alexander-armitage/AURA-FPGA/.github/aura_fpga.png

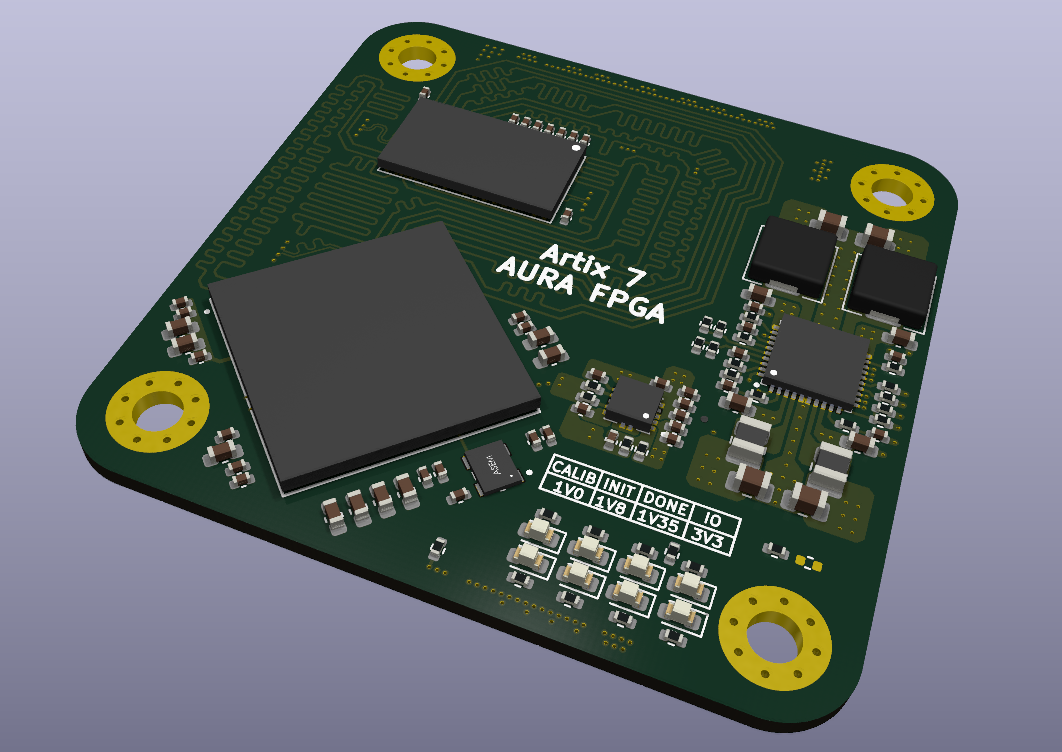
.github/aura_fpga.png
