alexander-armitage/AURA-FPGA/.github/aura_fpga_final_square.png

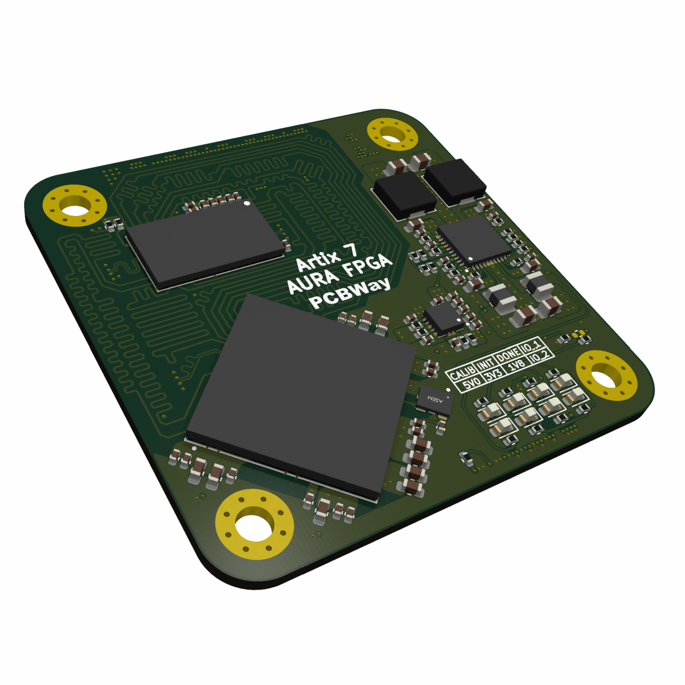
.github/aura_fpga_final_square.png
