alexander-armitage/AURA-FPGA/.github/aura_fpga_routing_square.png

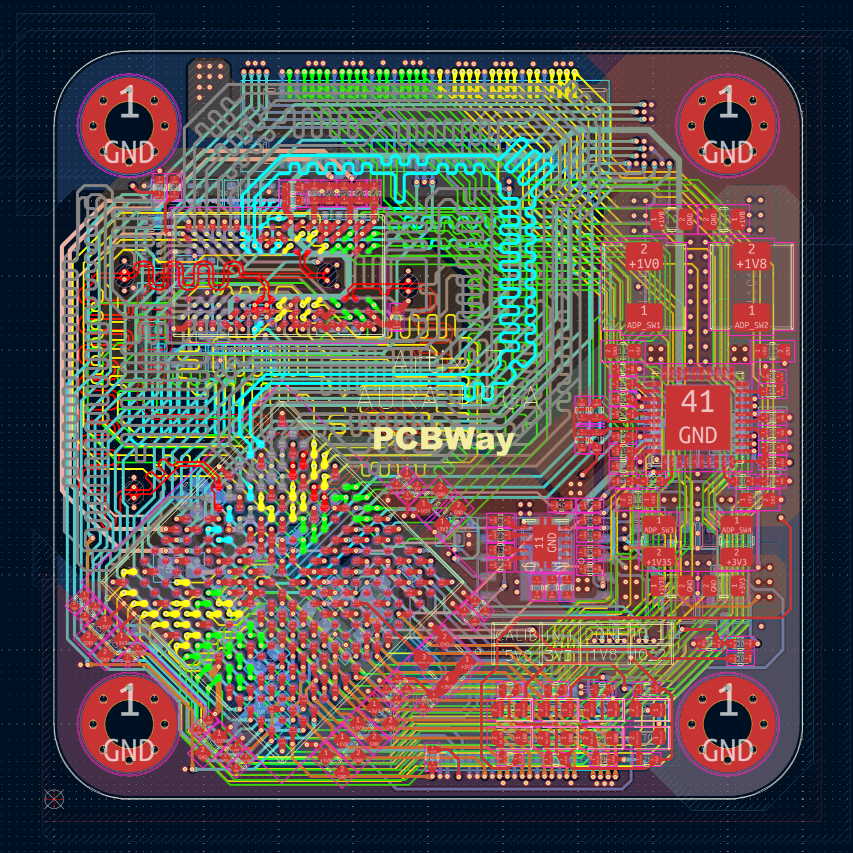
.github/aura_fpga_routing_square.png
