alexander-armitage/AURA-FPGA/FPGA_AURA/FPGA_AURA.kicad_pcb

## KiCad design FPGA_AURA/FPGA_AURA.kicad_pcb (2026-09-25)

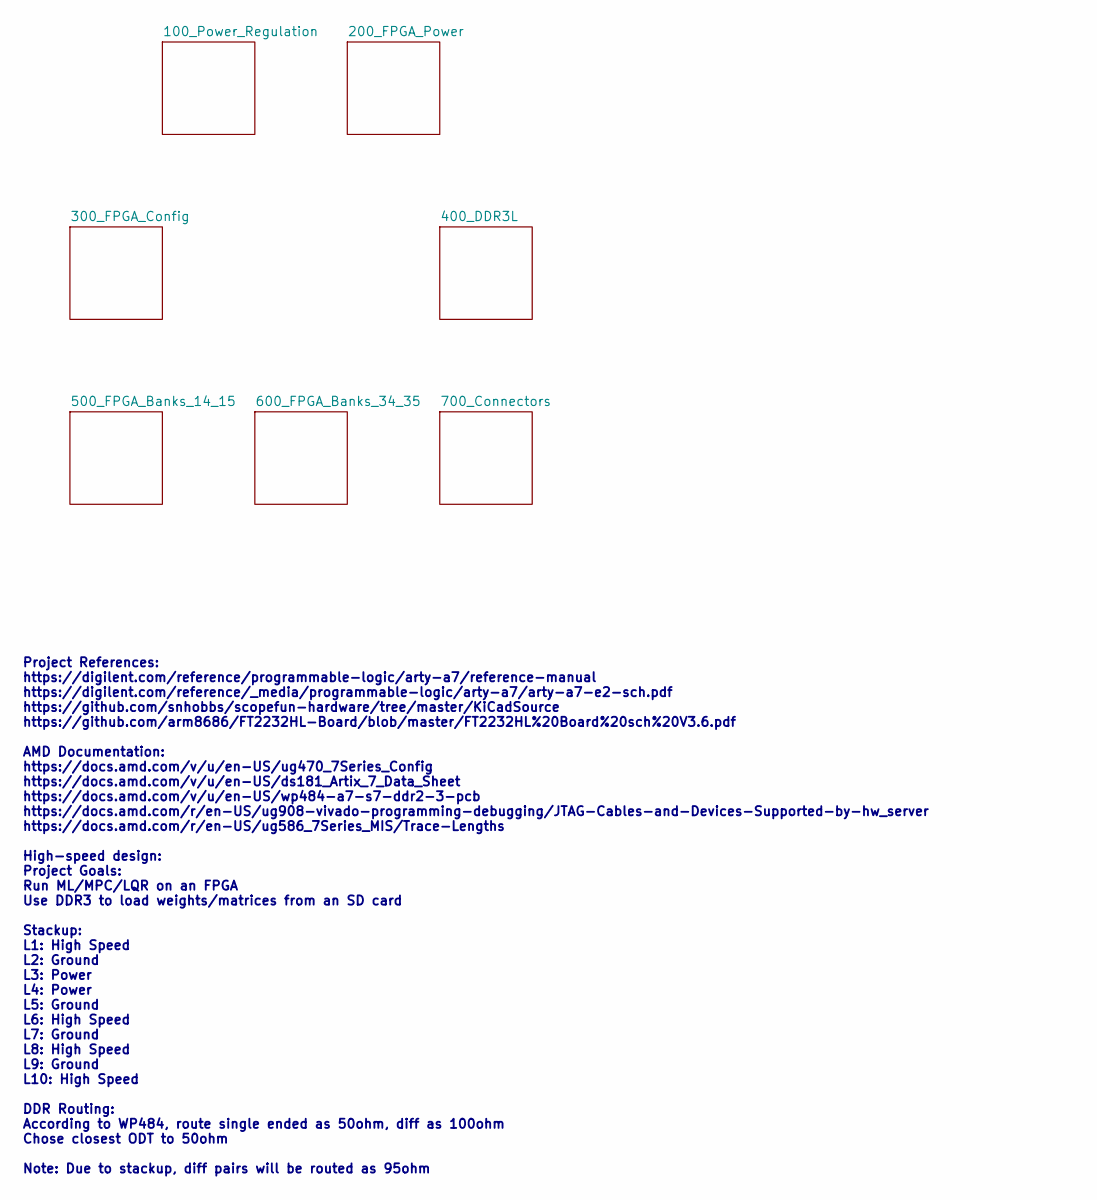
[picture p13: schematic FPGA_AURA.kicad_sch, FPGA AURA]

Notes on the sheet:
Project References: https://digilent.com/reference/programmable-logic/arty-a7/reference-manual https://digilent.com/reference/_media/programmable-logic/arty-a7/arty-a7-e2-sch.pdf https://github.com/snhobbs/scopefun-hardware/tree/master/KiCadSource https://github.com/arm8686/FT2232HL-Board/blob/mast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

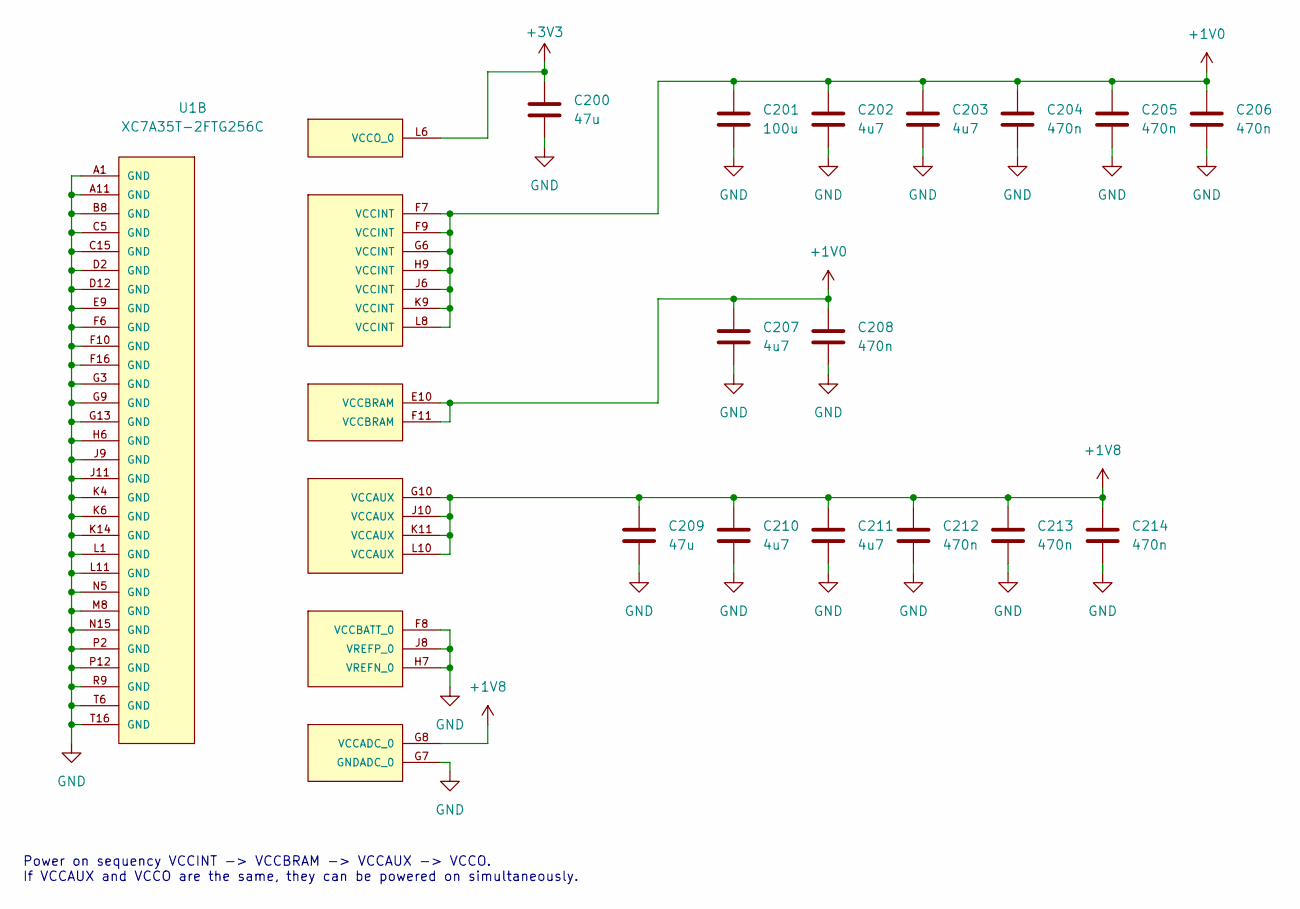
[picture p14: schematic FPGA_Power.kicad_sch, XC7A35T Power]

Parts:
C200, C209: 47u; C_0603_1608Metric
C201: 100u; C_0805_2012Metric
C202, C203, C207, C210, C211: 4u7; C_0603_1608Metric
C204, C205, C206, C208, C212, C213, C214: 470n; C_0402_1005Metric
U1: XC7A35T-2FTG256C; BGA256C100P16X16_1700X1700X155

Connections:
+1V0: C201.1, C202.1, C203.1, C204.1, C205.1, C206.1, C207.1, C208.1, U1.E10 (VCCBRAM), U1.F7 (VCCINT), U1.F9 (VCCINT), U1.F11 (VCCBRAM), U1.G6 (VCCINT), U1.H9 (VCCINT), U1.J6 (VCCINT), U1.K9 (VCCINT), U1.L8 (VCCINT); also elsewhere on the board
+1V8: C209.1, C210.1, C211.1, C212.1, C213.1, C214.1, U1.G8 (VCCADC_0), U1.G10 (VCCAUX), U1.J10 (VCCAUX), U1.K11 (VCCAUX), U1.L10 (VCCAUX); also elsewhere on the board
+3V3: C200.1, U1.L6 (VCCO_0); also elsewhere on the board
GND: C200.2, C201.2, C202.2, C203.2, C204.2, C205.2, C206.2, C207.2, C208.2, C209.2, C210.2, C211.2, C212.2, C213.2, C214.2, U1.A1 (GND), U1.A11 (GND), U1.B8 (GND), U1.C5 (GND), U1.C15 (GND), U1.D2 (GND), U1.D12 (GND), U1.E9 (GND), U1.F6 (GND), U1.F8 (VCCBATT_0), U1.F10 (GND), U1.F16 (GND), U1.G3 (GND), U1.G7 (GNDADC_0), U1.G9 (GND), U1.G13 (GND), U1.H6 (GND), U1.H7 (VREFN_0), U1.J8 (VREFP_0), U1.J9 (GND), U1.J11 (GND), U1.K4 (GND), U1.K6 (GND), U1.K14 (GND), U1.L1 (GND), U1.L11 (GND), U1.M8 (GND), U1.N5 (GND), U1.N15 (GND), U1.P2 (GND), U1.P12 (GND), U1.R9 (GND), U1.T6 (GND), U1.T16 (GND); also elsewhere on the board

Notes on the sheet:
Power on sequency VCCINT -> VCCBRAM -> VCCAUX -> VCCO. If VCCAUX and VCCO are the same, they can be powered on simultaneously.

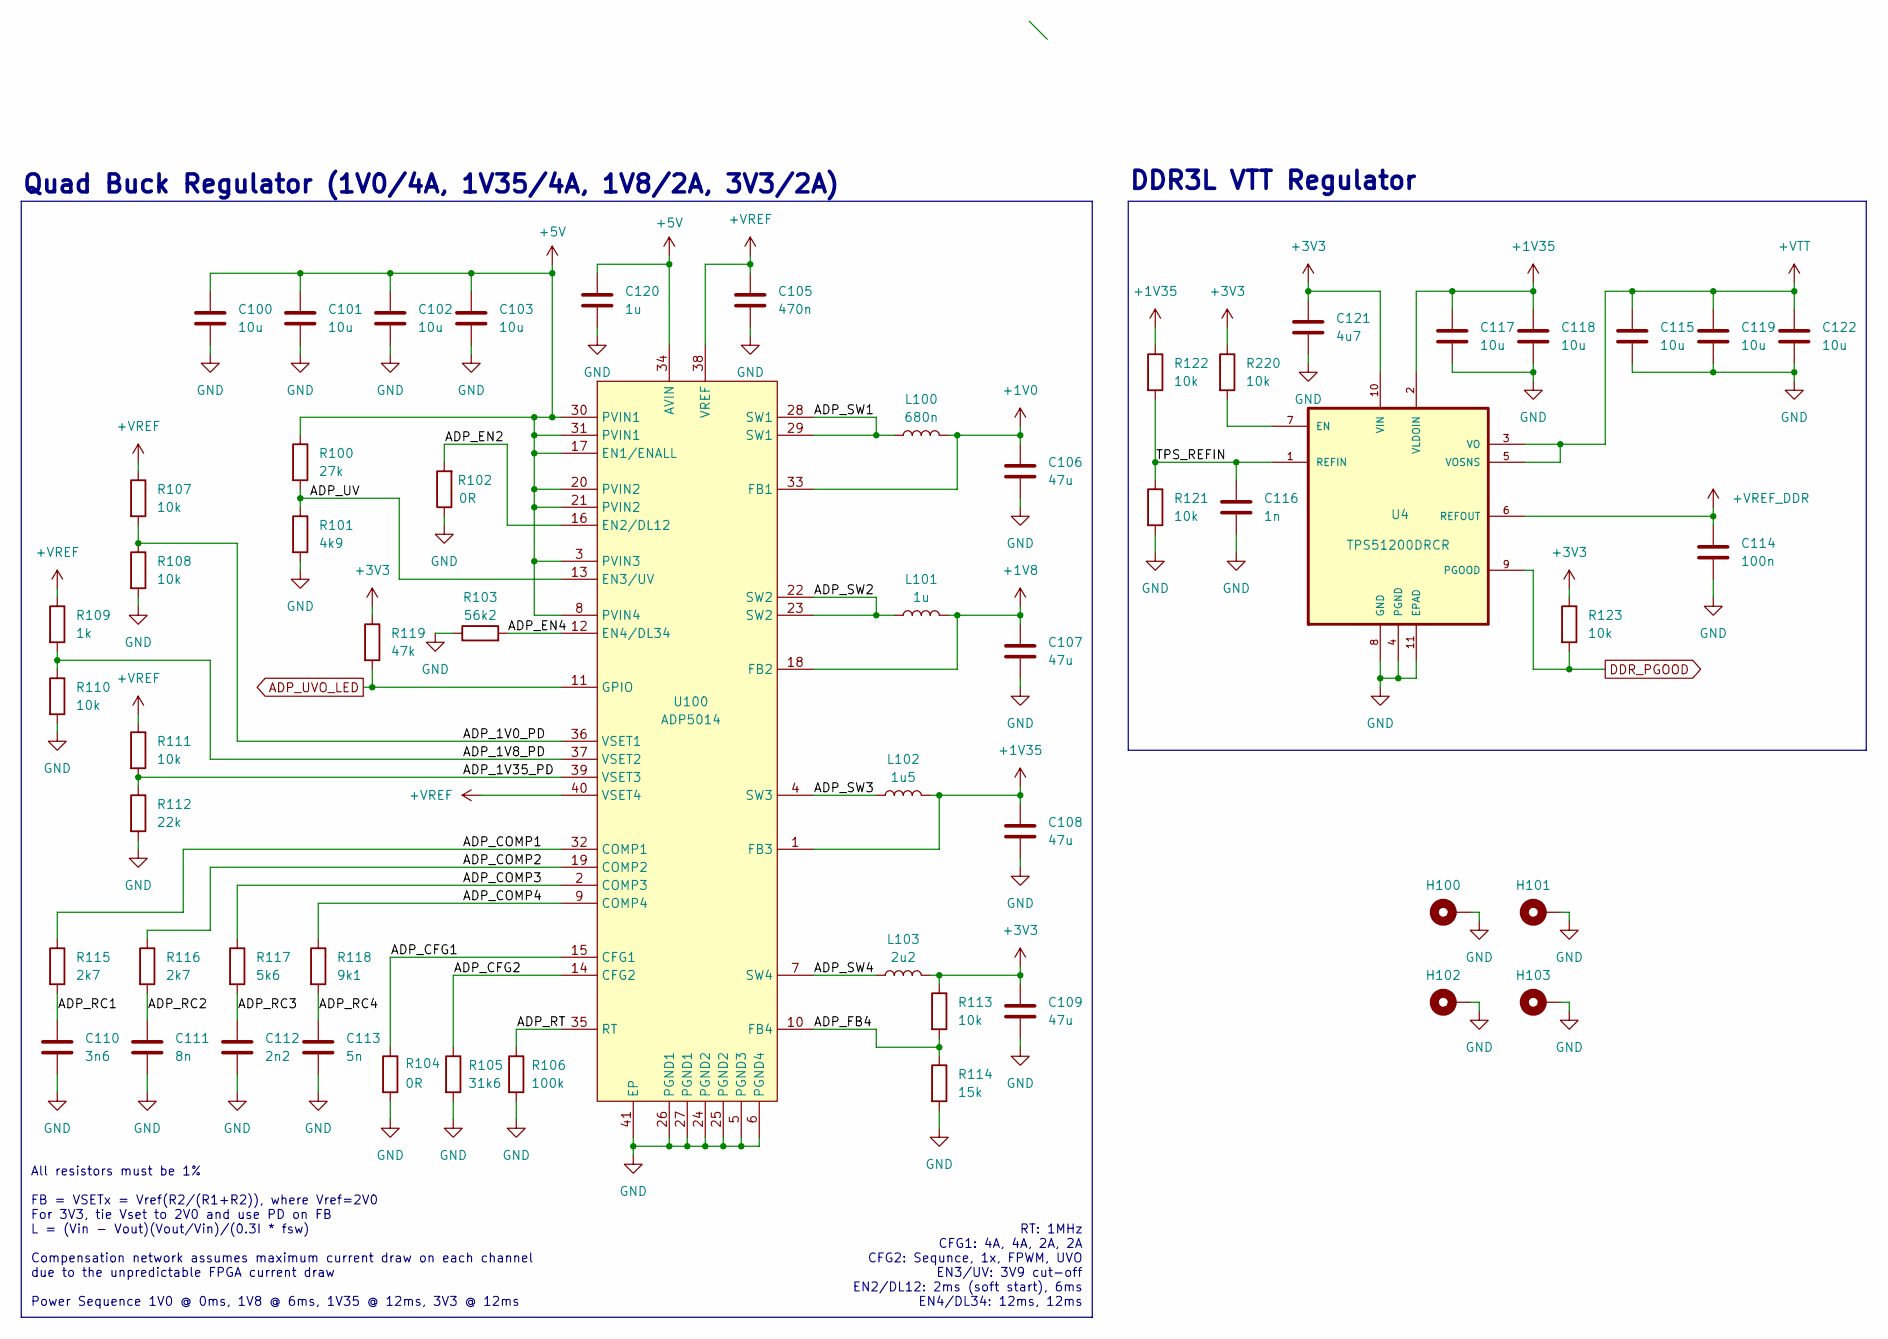
[picture p15: schematic Power_Regulation.kicad_sch, Power Regulation]

Parts:
C100, C101, C102, C103: 10u; C_0603_1608Metric
C105: 470n; C_0402_1005Metric
C106, C107, C108, C109: 47u; C_0805_2012Metric
C110: 3n6; C_0402_1005Metric
C111: 8n; C_0402_1005Metric
C112: 2n2; C_0402_1005Metric
C113: 5n; C_0402_1005Metric
C114: 100n; C_0402_1005Metric
C115, C117, C118, C119, C122: 10u; C_0402_1005Metric
C116: 1n; C_0402_1005Metric
C120: 1u; C_0402_1005Metric
C121: 4u7; C_0402_1005Metric
H100, H101, H102, H103: MountingHole_Pad; MountingHole_3.2mm_M3_Pad_Via
L100: 680n; L_Chilisin_BMRB00050518-B
L101: 1u; L_Chilisin_BMRB00050518-B
L102: 1u5; L_1008_2520Metric
L103: 2u2; L_1008_2520Metric
R100: 27k; R_0402_1005Metric
R101: 4k9; R_0402_1005Metric
R102, R104: 0R; R_0402_1005Metric
R103: 56k2; R_0402_1005Metric
R105: 31k6; R_0402_1005Metric
R106: 100k; R_0402_1005Metric
R107, R108, R110, R111, R113, R121, R122, R123, R220: 10k; R_0402_1005Metric
R109: 1k; R_0402_1005Metric
R112: 22k; R_0402_1005Metric
R114: 15k; R_0402_1005Metric
R115, R116: 2k7; R_0402_1005Metric
R117: 5k6; R_0402_1005Metric
R118: 9k1; R_0402_1005Metric
R119: 47k; R_0402_1005Metric
U4: TPS51200DRCR; VREG_V62_16624-01YE
U100: ADP5014; QFN50P600X600X80-41N430X430

Connections:
+1V0: C106.1, L100.2, U100.33 (FB1); also elsewhere on the board
+1V8: C107.1, L101.2, U100.18 (FB2); also elsewhere on the board
+1V35: C108.1, C117.1, C118.1, L102.2, R122.1, U4.2 (VLDOIN), U100.1 (FB3); also elsewhere on the board
+3V3: C109.1, C121.1, L103.2, R113.1, R119.1, R123.1, R220.1, U4.10 (VIN); also elsewhere on the board
+5V: C100.1, C101.1, C102.1, C103.1, C120.1, R100.1, U100.3 (PVIN3), U100.8 (PVIN4), U100.17 (EN1/ENALL), U100.20 (PVIN2), U100.21 (PVIN2), U100.30 (PVIN1), U100.31 (PVIN1), U100.34 (AVIN); also elsewhere on the board
+VREF: C105.1, R107.1, R109.1, R111.1, U100.38 (VREF), U100.40 (VSET4)
+VREF_DDR: C114.1, U4.6 (REFOUT); also elsewhere on the board
+VTT: C115.1, C119.1, C122.1, U4.3 (VO), U4.5 (VOSNS); also elsewhere on the board
/100_Power_Regulation/ADP_1V0_PD: R107.2, R108.1, U100.36 (VSET1)
/100_Power_Regulation/ADP_1V8_PD: R109.2, R110.1, U100.37 (VSET2)
/100_Power_Regulation/ADP_1V35_PD: R111.2, R112.1, U100.39 (VSET3)
/100_Power_Regulation/ADP_CFG1: R104.1, U100.15 (CFG1)
/100_Power_Regulation/ADP_CFG2: R105.1, U100.14 (CFG2)
/100_Power_Regulation/ADP_COMP1: R115.1, U100.32 (COMP1)
/100_Power_Regulation/ADP_COMP2: R116.1, U100.19 (COMP2)
/100_Power_Regulation/ADP_COMP3: R117.1, U100.2 (COMP3)
/100_Power_Regulation/ADP_COMP4: R118.1, U100.9 (COMP4)
/100_Power_Regulation/ADP_EN2: R102.2, U100.16 (EN2/DL12)
/100_Power_Regulation/ADP_EN4: R103.2, U100.12 (EN4/DL34)
/100_Power_Regulation/ADP_FB4: R113.2, R114.1, U100.10 (FB4)
/100_Power_Regulation/ADP_RC1: C110.1, R115.2
/100_Power_Regulation/ADP_RC2: C111.1, R116.2
/100_Power_Regulation/ADP_RC3: C112.1, R117.2
/100_Power_Regulation/ADP_RC4: C113.1, R118.2
/100_Power_Regulation/ADP_RT: R106.1, U100.35 (RT)
/100_Power_Regulation/ADP_SW1: L100.1, U100.28 (SW1), U100.29 (SW1)
/100_Power_Regulation/ADP_SW2: L101.1, U100.22 (SW2), U100.23 (SW2)
/100_Power_Regulation/ADP_SW3: L102.1, U100.4 (SW3)
/100_Power_Regulation/ADP_SW4: L103.1, U100.7 (SW4)
/100_Power_Regulation/ADP_UV: R100.2, R101.1, U100.13 (EN3/UV)
/100_Power_Regulation/TPS_REFIN: C116.1, R121.1, R122.2, U4.1 (REFIN)
ADP_UVO_LED: R119.2, U100.11 (GPIO)
DDR_PGOOD: R123.2, U4.9 (PGOOD)
GND: C100.2, C101.2, C102.2, C103.2, C105.2, C106.2, C107.2, C108.2, C109.2, C110.2, C111.2, C112.2, C113.2, C114.2, C115.2, C116.2, C117.2, C118.2, C119.2, C120.2, C121.2, C122.2, H100.1 (1_1), H101.1 (1_1), H102.1 (1_1), H103.1 (1_1), R101.2, R102.1, R103.1, R104.2, R105.2, R106.2, R108.2, R110.2, R112.2, R114.2, R121.2, U4.4 (PGND), U4.8 (GND), U4.11 (EPAD), U100.5 (PGND3), U100.6 (PGND4), U100.24 (PGND2), U100.25 (PGND2), U100.26 (PGND1), U100.27 (PGND1), U100.41 (EP); also elsewhere on the board
unnamed: R220.2, U4.7 (EN)

Notes on the sheet:
DDR3L VTT Regulator
Quad Buck Regulator (1V0/4A, 1V35/4A, 1V8/2A, 3V3/2A)
All resistors must be 1% FB = VSETx = Vref(R2/(R1+R2)), where Vref=2V0 For 3V3, tie Vset to 2V0 and use PD on FB L = (Vin - Vout)(Vout/Vin)/(0.3I * fsw) Compensation network assumes maximum current draw on each channel due to the unpredictable FPGA current draw Power Sequence 1V0 @ 0ms, 1V8 @ 6ms, 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
RT: 1MHz CFG1: 4A, 4A, 2A, 2A CFG2: Sequnce, 1x, FPWM, UVO EN3/UV: 3V9 cut-off EN2/DL12: 2ms (soft start), 6ms EN4/DL34: 12ms, 12ms

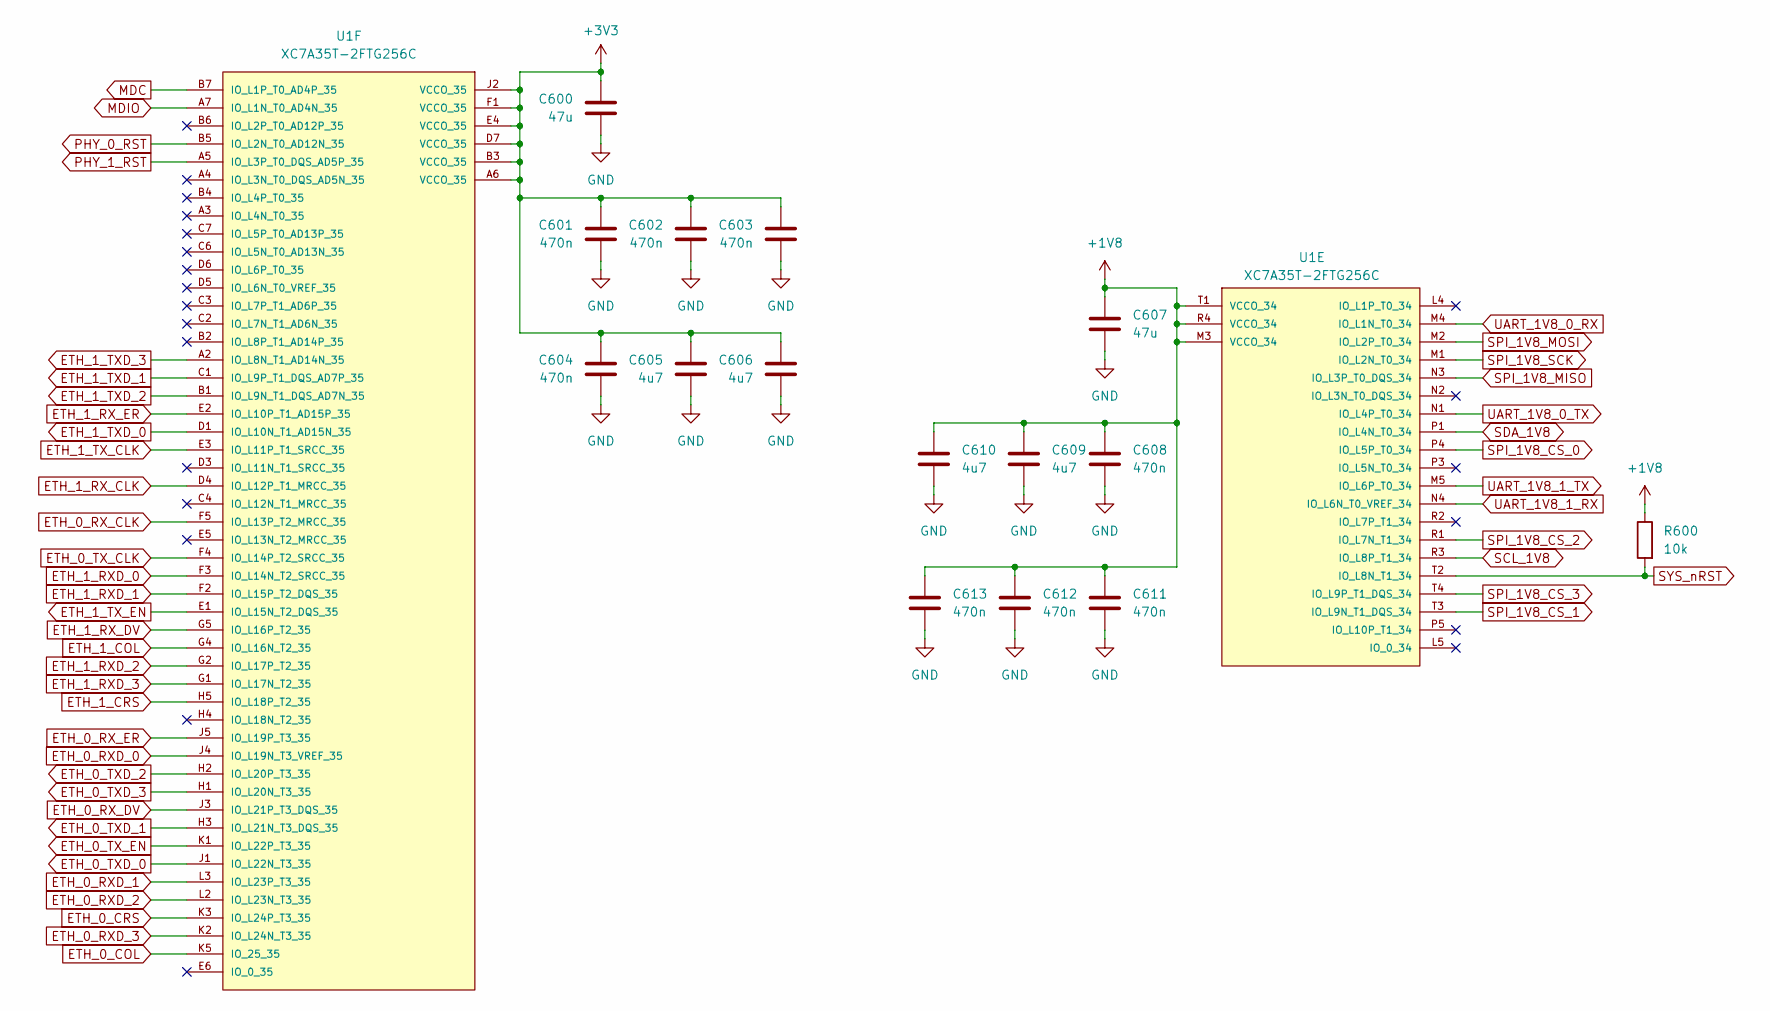
[picture p16: schematic FPGA_Banks_34_35.kicad_sch, XC7A35T Banks 34, 35]

Parts:
C600, C607: 47u; C_0603_1608Metric
C601, C602, C603, C604, C608, C611, C612, C613: 470n; C_0402_1005Metric
C605, C606, C609, C610: 4u7; C_0603_1608Metric
R600: 10k; R_0402_1005Metric
U1: XC7A35T-2FTG256C; BGA256C100P16X16_1700X1700X155

Connections:
+1V8: C607.1, C608.1, C609.1, C610.1, C611.1, C612.1, C613.1, R600.1, U1.M3 (VCCO_34), U1.R4 (VCCO_34), U1.T1 (VCCO_34); also elsewhere on the board
+3V3: C600.1, C601.1, C602.1, C603.1, C604.1, C605.1, C606.1, U1.A6 (VCCO_35), U1.B3 (VCCO_35), U1.D7 (VCCO_35), U1.E4 (VCCO_35), U1.F1 (VCCO_35), U1.J2 (VCCO_35); also elsewhere on the board
ETH_0_COL: U1.K5 (IO_25_35); also elsewhere on the board
ETH_0_CRS: U1.K3 (IO_L24P_T3_35); also elsewhere on the board
ETH_0_RXD_0: U1.J4 (IO_L19N_T3_VREF_35); also elsewhere on the board
ETH_0_RXD_1: U1.L3 (IO_L23P_T3_35); also elsewhere on the board
ETH_0_RXD_2: U1.L2 (IO_L23N_T3_35); also elsewhere on the board
ETH_0_RXD_3: U1.K2 (IO_L24N_T3_35); also elsewhere on the board
ETH_0_RX_CLK: U1.F5 (IO_L13P_T2_MRCC_35); also elsewhere on the board
ETH_0_RX_DV: U1.J3 (IO_L21P_T3_DQS_35); also elsewhere on the board
ETH_0_RX_ER: U1.J5 (IO_L19P_T3_35); also elsewhere on the board
ETH_0_TXD_0: U1.J1 (IO_L22N_T3_35); also elsewhere on the board
ETH_0_TXD_1: U1.H3 (IO_L21N_T3_DQS_35); also elsewhere on the board
ETH_0_TXD_2: U1.H2 (IO_L20P_T3_35); also elsewhere on the board
ETH_0_TXD_3: U1.H1 (IO_L20N_T3_35); also elsewhere on the board
ETH_0_TX_CLK: U1.F4 (IO_L14P_T2_SRCC_35); also elsewhere on the board
ETH_0_TX_EN: U1.K1 (IO_L22P_T3_35); also elsewhere on the board
ETH_1_COL: U1.G4 (IO_L16N_T2_35); also elsewhere on the board
ETH_1_CRS: U1.H5 (IO_L18P_T2_35); also elsewhere on the board
ETH_1_RXD_0: U1.F3 (IO_L14N_T2_SRCC_35); also elsewhere on the board
ETH_1_RXD_1: U1.F2 (IO_L15P_T2_DQS_35); also elsewhere on the board
ETH_1_RXD_2: U1.G2 (IO_L17P_T2_35); also elsewhere on the board
ETH_1_RXD_3: U1.G1 (IO_L17N_T2_35); also elsewhere on the board
ETH_1_RX_CLK: U1.D4 (IO_L12P_T1_MRCC_35); also elsewhere on the board
ETH_1_RX_DV: U1.G5 (IO_L16P_T2_35); also elsewhere on the board
ETH_1_RX_ER: U1.E2 (IO_L10P_T1_AD15P_35); also elsewhere on the board
ETH_1_TXD_0: U1.D1 (IO_L10N_T1_AD15N_35); also elsewhere on the board
ETH_1_TXD_1: U1.C1 (IO_L9P_T1_DQS_AD7P_35); also elsewhere on the board
ETH_1_TXD_2: U1.B1 (IO_L9N_T1_DQS_AD7N_35); also elsewhere on the board
ETH_1_TXD_3: U1.A2 (IO_L8N_T1_AD14N_35); also elsewhere on the board
ETH_1_TX_CLK: U1.E3 (IO_L11P_T1_SRCC_35); also elsewhere on the board
ETH_1_TX_EN: U1.E1 (IO_L15N_T2_DQS_35); also elsewhere on the board
GND: C600.2, C601.2, C602.2, C603.2, C604.2, C605.2, C606.2, C607.2, C608.2, C609.2, C610.2, C611.2, C612.2, C613.2; also elsewhere on the board
MDC: U1.B7 (IO_L1P_T0_AD4P_35); also elsewhere on the board
MDIO: U1.A7 (IO_L1N_T0_AD4N_35); also elsewhere on the board
PHY_0_RST: U1.B5 (IO_L2N_T0_AD12N_35); also elsewhere on the board
PHY_1_RST: U1.A5 (IO_L3P_T0_DQS_AD5P_35); also elsewhere on the board
SCL_1V8: U1.R3 (IO_L8P_T1_34); also elsewhere on the board
SDA_1V8: U1.P1 (IO_L4N_T0_34); also elsewhere on the board
SPI_1V8_CS_0: U1.P4 (IO_L5P_T0_34); also elsewhere on the board
SPI_1V8_CS_1: U1.T3 (IO_L9N_T1_DQS_34); also elsewhere on the board
SPI_1V8_CS_2: U1.R1 (IO_L7N_T1_34); also elsewhere on the board
SPI_1V8_CS_3: U1.T4 (IO_L9P_T1_DQS_34); also elsewhere on the board
SPI_1V8_MISO: U1.N3 (IO_L3P_T0_DQS_34); also elsewhere on the board
SPI_1V8_MOSI: U1.M2 (IO_L2P_T0_34); also elsewhere on the board
SPI_1V8_SCK: U1.M1 (IO_L2N_T0_34); also elsewhere on the board
SYS_nRST: R600.2, U1.T2 (IO_L8N_T1_34); also elsewhere on the board
UART_1V8_0_RX: U1.M4 (IO_L1N_T0_34); also elsewhere on the board
UART_1V8_0_TX: U1.N1 (IO_L4P_T0_34); also elsewhere on the board
UART_1V8_1_RX: U1.N4 (IO_L6N_T0_VREF_34); also elsewhere on the board
UART_1V8_1_TX: U1.M5 (IO_L6P_T0_34); also elsewhere on the board

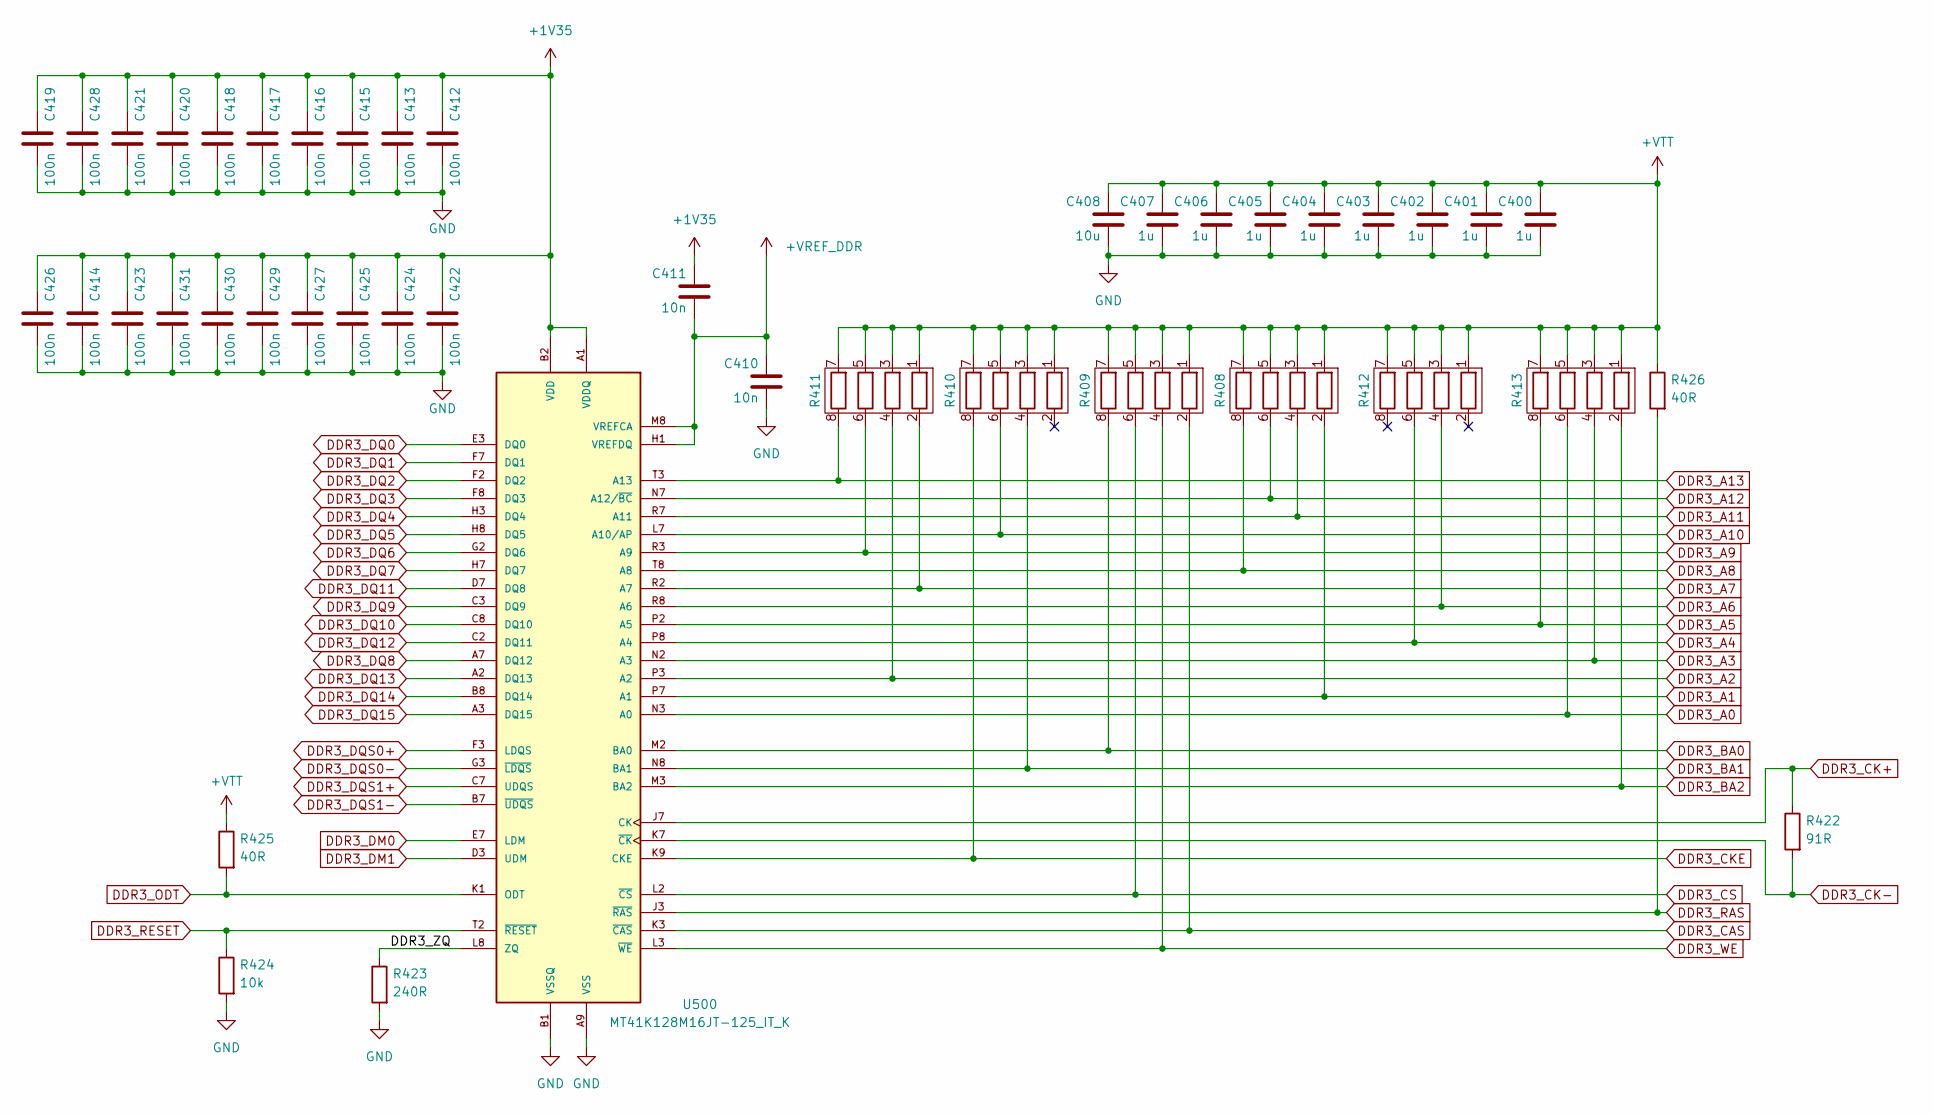
[picture p17: schematic DDR3L.kicad_sch]

Parts:
C400, C401, C402, C403, C404, C405, C406, C407: 1u; C_0402_1005Metric
C408: 10u; C_0402_1005Metric
C410, C411: 10n; C_0402_1005Metric
C412, C413, C417, C421, C422, C431: 100n; C_0402_1005Metric
C414, C415, C416, C418, C419, C420, C423, C424, C425, C426, C427, C428, C429, C430: 100n; C_0201_0603Metric
R408, R409, R410, R411, R412, R413: 40R2; 0402_4
R422: 91R; R_0201_0603Metric
R423: 240R; R_0402_1005Metric
R424: 10k; R_0402_1005Metric
R425, R426: 40R; R_0201_0603Metric
U500: MT41K128M16JT-125_IT_K; BGA80P96C6X16_800X1400X110

Connections:
+1V35: C411.1, C412.1, C413.1, C414.1, C415.1, C416.1, C417.1, C418.1, C419.1, C420.1, C421.1, C422.1, C423.1, C424.1, C425.1, C426.1, C427.1, C428.1, C429.1, C430.1, C431.1, U500.A1 (VDDQ), U500.A8 (VDDQ), U500.B2 (VDD), U500.C1 (VDDQ), U500.C9 (VDDQ), U500.D2 (VDDQ), U500.D9 (VDD), U500.E9 (VDDQ), U500.F1 (VDDQ), U500.G7 (VDD), U500.H2 (VDDQ), U500.H9 (VDDQ), U500.K2 (VDD), U500.K8 (VDD), U500.N1 (VDD), U500.N9 (VDD), U500.R1 (VDD), U500.R9 (VDD); also elsewhere on the board
+VREF_DDR: C410.1, C411.2, U500.H1 (VREFDQ), U500.M8 (VREFCA); also elsewhere on the board
+VTT: C400.1, C401.1, C402.1, C403.1, C404.1, C405.1, C406.1, C407.1, C408.1, R408.1, R408.3, R408.5, R408.7, R409.1, R409.3, R409.5, R409.7, R410.1, R410.3, R410.5, R410.7, R411.1, R411.3, R411.5, R411.7, R412.1, R412.3, R412.5, R412.7, R413.1, R413.3, R413.5, R413.7, R425.1, R426.1; also elsewhere on the board
/400_DDR3L/DDR3_ZQ: R423.1, U500.L8 (ZQ)
DDR3_A0: R413.6, U500.N3 (A0); also elsewhere on the board
DDR3_A1: R408.2, U500.P7 (A1); also elsewhere on the board
DDR3_A2: R411.4, U500.P3 (A2); also elsewhere on the board
DDR3_A3: R413.4, U500.N2 (A3); also elsewhere on the board
DDR3_A4: R412.6, U500.P8 (A4); also elsewhere on the board
DDR3_A5: R413.8, U500.P2 (A5); also elsewhere on the board
DDR3_A6: R412.4, U500.R8 (A6); also elsewhere on the board
DDR3_A7: R411.2, U500.R2 (A7); also elsewhere on the board
DDR3_A8: R408.8, U500.T8 (A8); also elsewhere on the board
DDR3_A9: R411.6, U500.R3 (A9); also elsewhere on the board
DDR3_A10: R410.6, U500.L7 (A10/AP); also elsewhere on the board
DDR3_A11: R408.4, U500.R7 (A11); also elsewhere on the board
DDR3_A12: R408.6, U500.N7 (A12/~BC); also elsewhere on the board
DDR3_A13: R411.8, U500.T3 (A13); also elsewhere on the board
DDR3_BA0: R409.8, U500.M2 (BA0); also elsewhere on the board
DDR3_BA1: R410.4, U500.N8 (BA1); also elsewhere on the board
DDR3_BA2: R413.2, U500.M3 (BA2); also elsewhere on the board
DDR3_CAS: R409.2, U500.K3 (~CAS); also elsewhere on the board
DDR3_CK+: R422.1, U500.J7 (CK); also elsewhere on the board
DDR3_CK-: R422.2, U500.K7 (~CK); also elsewhere on the board
DDR3_CKE: R410.8, U500.K9 (CKE); also elsewhere on the board
DDR3_CS: R409.6, U500.L2 (~CS); also elsewhere on the board
DDR3_DM0: U500.E7 (LDM); also elsewhere on the board
DDR3_DM1: U500.D3 (UDM); also elsewhere on the board
DDR3_DQ0: U500.E3 (DQ0); also elsewhere on the board
DDR3_DQ1: U500.F7 (DQ1); also elsewhere on the board
DDR3_DQ2: U500.F2 (DQ2); also elsewhere on the board
DDR3_DQ3: U500.F8 (DQ3); also elsewhere on the board
DDR3_DQ4: U500.H3 (DQ4); also elsewhere on the board
DDR3_DQ5: U500.H8 (DQ5); also elsewhere on the board
DDR3_DQ6: U500.G2 (DQ6); also elsewhere on the board
DDR3_DQ7: U500.H7 (DQ7); also elsewhere on the board
DDR3_DQ8: U500.A7 (DQ12); also elsewhere on the board
DDR3_DQ9: U500.C3 (DQ9); also elsewhere on the board
DDR3_DQ10: U500.C8 (DQ10); also elsewhere on the board
DDR3_DQ11: U500.D7 (DQ8); also elsewhere on the board
DDR3_DQ12: U500.C2 (DQ11); also elsewhere on the board
DDR3_DQ13: U500.A2 (DQ13); also elsewhere on the board
DDR3_DQ14: U500.B8 (DQ14); also elsewhere on the board
DDR3_DQ15: U500.A3 (DQ15); also elsewhere on the board
DDR3_DQS0+: U500.F3 (LDQS); also elsewhere on the board
DDR3_DQS0-: U500.G3 (~LDQS); also elsewhere on the board
DDR3_DQS1+: U500.C7 (UDQS); also elsewhere on the board
DDR3_DQS1-: U500.B7 (~UDQS); also elsewhere on the board
DDR3_ODT: R425.2, U500.K1 (ODT); also elsewhere on the board
DDR3_RAS: R426.2, U500.J3 (~RAS); also elsewhere on the board
DDR3_RESET: R424.1, U500.T2 (~RESET); also elsewhere on the board
DDR3_WE: R409.4, U500.L3 (~WE); also elsewhere on the board
GND: C400.2, C401.2, C402.2, C403.2, C404.2, C405.2, C406.2, C407.2, C408.2, C410.2, C412.2, C413.2, C414.2, C415.2, C416.2, C417.2, C418.2, C419.2, C420.2, C421.2, C422.2, C423.2, C424.2, C425.2, C426.2, C427.2, C428.2, C429.2, C430.2, C431.2, R423.2, R424.2, U500.A9 (VSS), U500.B1 (VSSQ), U500.B3 (VSS), U500.B9 (VSSQ), U500.D1 (VSSQ), U500.D8 (VSSQ), U500.E1 (VSS), U500.E2 (VSSQ), U500.E8 (VSSQ), U500.F9 (VSSQ), U500.G1 (VSSQ), U500.G8 (VSS), U500.G9 (VSSQ), U500.J2 (VSS), U500.J8 (VSS), U500.M1 (VSS), U500.M9 (VSS), U500.P1 (VSS), U500.P9 (VSS), U500.T1 (VSS), U500.T9 (VSS); also elsewhere on the board
