alexander-armitage/AURA-FPGA/FPGA_AURA/FPGA_AURA.kicad_pcb

## KiCad design FPGA_AURA/FPGA_AURA.kicad_pcb (continued)

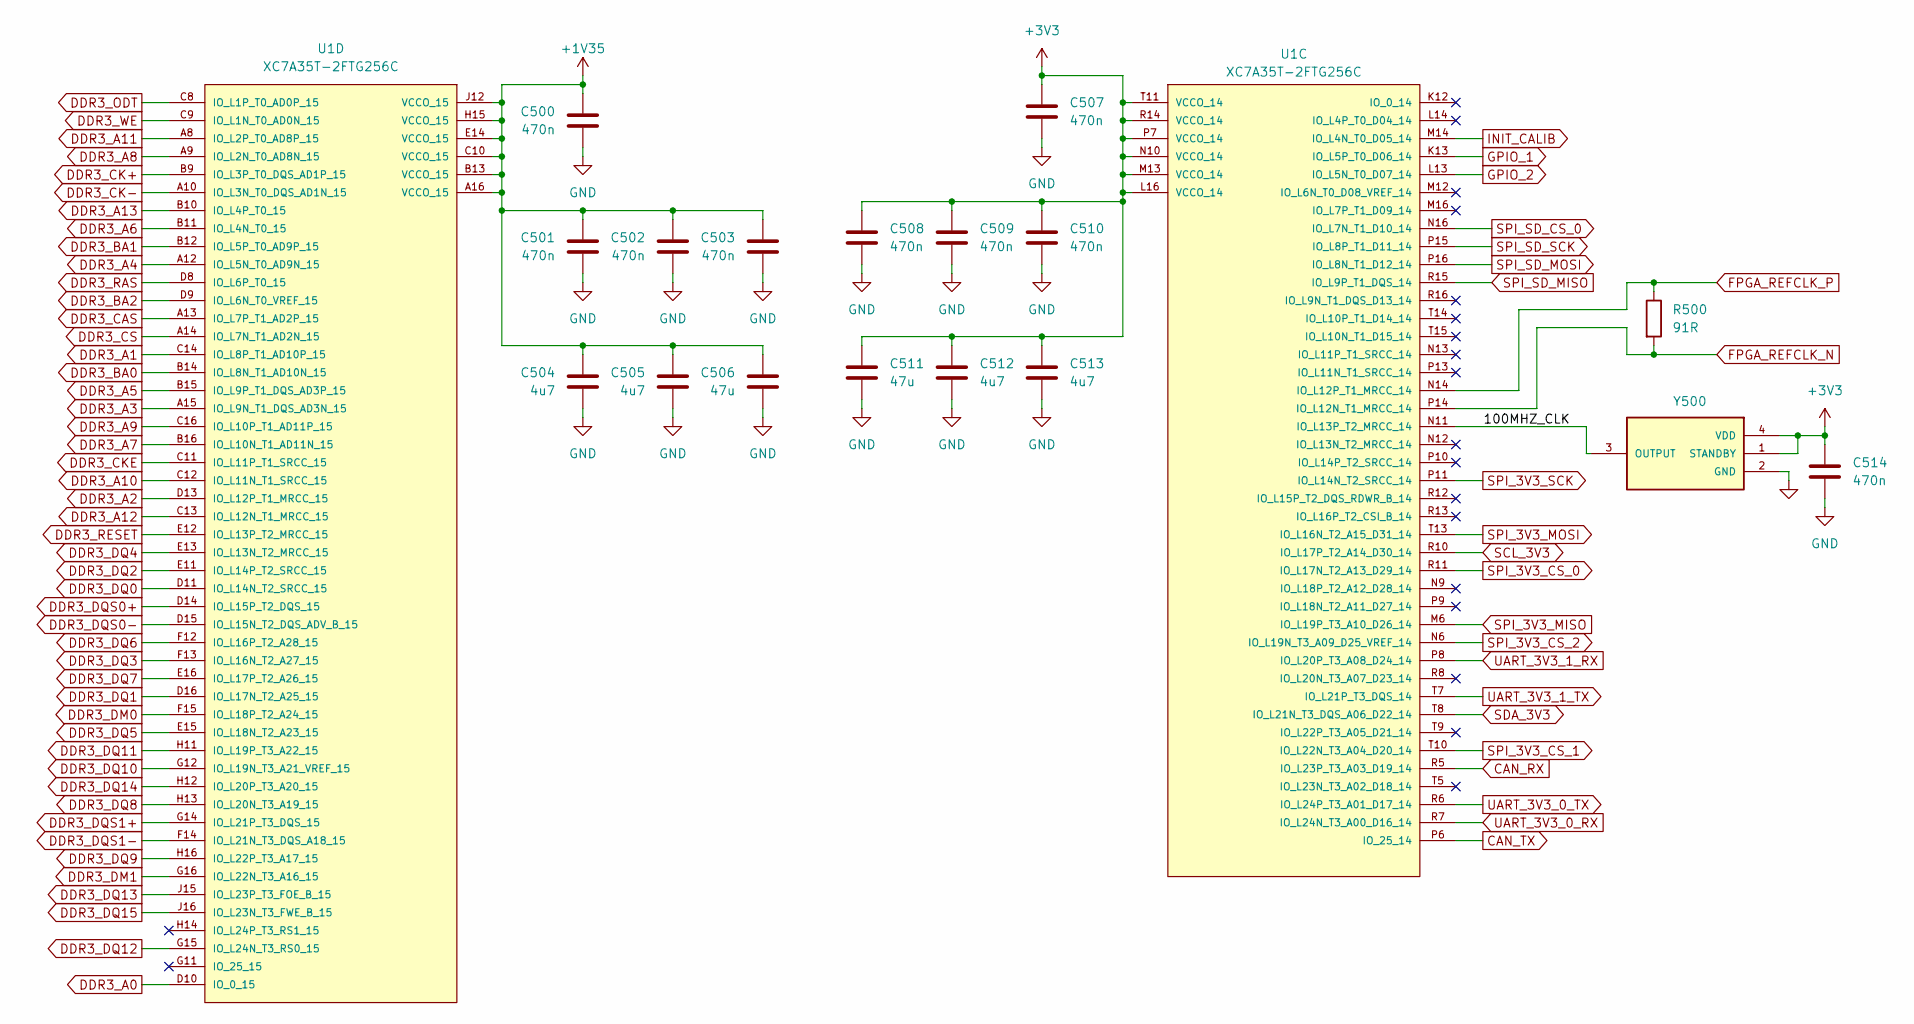
[picture p18: schematic FPGA_Banks_14_15.kicad_sch, XC7A35T Banks 14, 15]

Parts:
C500, C501, C502, C503, C507, C508, C509, C510, C514: 470n; C_0402_1005Metric
C504, C505, C512, C513: 4u7; C_0603_1608Metric
C506, C511: 47u; C_0603_1608Metric
R500: 91R; R_0201_0603Metric
U1: XC7A35T-2FTG256C; BGA256C100P16X16_1700X1700X155
Y500: ASEM1-100.000MHZ-LC-T; XTAL_ASEM1-100.000MHZ-LC-T; PARTREV 1.4.2021

Connections:
+1V35: C500.1, C501.1, C502.1, C503.1, C504.1, C505.1, C506.1, U1.A16 (VCCO_15), U1.B13 (VCCO_15), U1.C10 (VCCO_15), U1.E14 (VCCO_15), U1.H15 (VCCO_15), U1.J12 (VCCO_15); also elsewhere on the board
+3V3: C507.1, C508.1, C509.1, C510.1, C511.1, C512.1, C513.1, C514.1, U1.L16 (VCCO_14), U1.M13 (VCCO_14), U1.N10 (VCCO_14), U1.P7 (VCCO_14), U1.R14 (VCCO_14), U1.T11 (VCCO_14), Y500.1 (STANDBY), Y500.4 (VDD); also elsewhere on the board
/500_FPGA_Banks_14_15/100MHZ_CLK: U1.N11 (IO_L13P_T2_MRCC_14), Y500.3 (OUTPUT)
CAN_RX: U1.R5 (IO_L23P_T3_A03_D19_14); also elsewhere on the board
CAN_TX: U1.P6 (IO_25_14); also elsewhere on the board
DDR3_A0: U1.D10 (IO_0_15); also elsewhere on the board
DDR3_A1: U1.C14 (IO_L8P_T1_AD10P_15); also elsewhere on the board
DDR3_A2: U1.D13 (IO_L12P_T1_MRCC_15); also elsewhere on the board
DDR3_A3: U1.A15 (IO_L9N_T1_DQS_AD3N_15); also elsewhere on the board
DDR3_A4: U1.A12 (IO_L5N_T0_AD9N_15); also elsewhere on the board
DDR3_A5: U1.B15 (IO_L9P_T1_DQS_AD3P_15); also elsewhere on the board
DDR3_A6: U1.B11 (IO_L4N_T0_15); also elsewhere on the board
DDR3_A7: U1.B16 (IO_L10N_T1_AD11N_15); also elsewhere on the board
DDR3_A8: U1.A9 (IO_L2N_T0_AD8N_15); also elsewhere on the board
DDR3_A9: U1.C16 (IO_L10P_T1_AD11P_15); also elsewhere on the board
DDR3_A10: U1.C12 (IO_L11N_T1_SRCC_15); also elsewhere on the board
DDR3_A11: U1.A8 (IO_L2P_T0_AD8P_15); also elsewhere on the board
DDR3_A12: U1.C13 (IO_L12N_T1_MRCC_15); also elsewhere on the board
DDR3_A13: U1.B10 (IO_L4P_T0_15); also elsewhere on the board
DDR3_BA0: U1.B14 (IO_L8N_T1_AD10N_15); also elsewhere on the board
DDR3_BA1: U1.B12 (IO_L5P_T0_AD9P_15); also elsewhere on the board
DDR3_BA2: U1.D9 (IO_L6N_T0_VREF_15); also elsewhere on the board
DDR3_CAS: U1.A13 (IO_L7P_T1_AD2P_15); also elsewhere on the board
DDR3_CK+: U1.B9 (IO_L3P_T0_DQS_AD1P_15); also elsewhere on the board
DDR3_CK-: U1.A10 (IO_L3N_T0_DQS_AD1N_15); also elsewhere on the board
DDR3_CKE: U1.C11 (IO_L11P_T1_SRCC_15); also elsewhere on the board
DDR3_CS: U1.A14 (IO_L7N_T1_AD2N_15); also elsewhere on the board
DDR3_DM0: U1.F15 (IO_L18P_T2_A24_15); also elsewhere on the board
DDR3_DM1: U1.G16 (IO_L22N_T3_A16_15); also elsewhere on the board
DDR3_DQ0: U1.D11 (IO_L14N_T2_SRCC_15); also elsewhere on the board
DDR3_DQ1: U1.D16 (IO_L17N_T2_A25_15); also elsewhere on the board
DDR3_DQ2: U1.E11 (IO_L14P_T2_SRCC_15); also elsewhere on the board
DDR3_DQ3: U1.F13 (IO_L16N_T2_A27_15); also elsewhere on the board
DDR3_DQ4: U1.E13 (IO_L13N_T2_MRCC_15); also elsewhere on the board
DDR3_DQ5: U1.E15 (IO_L18N_T2_A23_15); also elsewhere on the board
DDR3_DQ6: U1.F12 (IO_L16P_T2_A28_15); also elsewhere on the board
DDR3_DQ7: U1.E16 (IO_L17P_T2_A26_15); also elsewhere on the board
DDR3_DQ8: U1.H13 (IO_L20N_T3_A19_15); also elsewhere on the board
DDR3_DQ9: U1.H16 (IO_L22P_T3_A17_15); also elsewhere on the board
DDR3_DQ10: U1.G12 (IO_L19N_T3_A21_VREF_15); also elsewhere on the board
DDR3_DQ11: U1.H11 (IO_L19P_T3_A22_15); also elsewhere on the board
DDR3_DQ12: U1.G15 (IO_L24N_T3_RS0_15); also elsewhere on the board
DDR3_DQ13: U1.J15 (IO_L23P_T3_FOE_B_15); also elsewhere on the board
DDR3_DQ14: U1.H12 (IO_L20P_T3_A20_15); also elsewhere on the board
DDR3_DQ15: U1.J16 (IO_L23N_T3_FWE_B_15); also elsewhere on the board
DDR3_DQS0+: U1.D14 (IO_L15P_T2_DQS_15); also elsewhere on the board
DDR3_DQS0-: U1.D15 (IO_L15N_T2_DQS_ADV_B_15); also elsewhere on the board
DDR3_DQS1+: U1.G14 (IO_L21P_T3_DQS_15); also elsewhere on the board
DDR3_DQS1-: U1.F14 (IO_L21N_T3_DQS_A18_15); also elsewhere on the board
DDR3_ODT: U1.C8 (IO_L1P_T0_AD0P_15); also elsewhere on the board
DDR3_RAS: U1.D8 (IO_L6P_T0_15); also elsewhere on the board
DDR3_RESET: U1.E12 (IO_L13P_T2_MRCC_15); also elsewhere on the board
DDR3_WE: U1.C9 (IO_L1N_T0_AD0N_15); also elsewhere on the board
FPGA_REFCLK_N: R500.2, U1.P14 (IO_L12N_T1_MRCC_14); also elsewhere on the board
FPGA_REFCLK_P: R500.1, U1.N14 (IO_L12P_T1_MRCC_14); also elsewhere on the board
GND: C500.2, C501.2, C502.2, C503.2, C504.2, C505.2, C506.2, C507.2, C508.2, C509.2, C510.2, C511.2, C512.2, C513.2, C514.2, Y500.2 (GND); also elsewhere on the board
GPIO_1: U1.K13 (IO_L5P_T0_D06_14); also elsewhere on the board
GPIO_2: U1.L13 (IO_L5N_T0_D07_14); also elsewhere on the board
INIT_CALIB: U1.M14 (IO_L4N_T0_D05_14); also elsewhere on the board
SCL_3V3: U1.R10 (IO_L17P_T2_A14_D30_14); also elsewhere on the board
SDA_3V3: U1.T8 (IO_L21N_T3_DQS_A06_D22_14); also elsewhere on the board
SPI_3V3_CS_0: U1.R11 (IO_L17N_T2_A13_D29_14); also elsewhere on the board
SPI_3V3_CS_1: U1.T10 (IO_L22N_T3_A04_D20_14); also elsewhere on the board
SPI_3V3_CS_2: U1.N6 (IO_L19N_T3_A09_D25_VREF_14); also elsewhere on the board
SPI_3V3_MISO: U1.M6 (IO_L19P_T3_A10_D26_14); also elsewhere on the board
SPI_3V3_MOSI: U1.T13 (IO_L16N_T2_A15_D31_14); also elsewhere on the board
SPI_3V3_SCK: U1.P11 (IO_L14N_T2_SRCC_14); also elsewhere on the board
SPI_SD_CS_0: U1.N16 (IO_L7N_T1_D10_14); also elsewhere on the board
SPI_SD_MISO: U1.R15 (IO_L9P_T1_DQS_14); also elsewhere on the board
SPI_SD_MOSI: U1.P16 (IO_L8N_T1_D12_14); also elsewhere on the board
SPI_SD_SCK: U1.P15 (IO_L8P_T1_D11_14); also elsewhere on the board
UART_3V3_0_RX: U1.R7 (IO_L24N_T3_A00_D16_14); also elsewhere on the board
UART_3V3_0_TX: U1.R6 (IO_L24P_T3_A01_D17_14); also elsewhere on the board
UART_3V3_1_RX: U1.P8 (IO_L20P_T3_A08_D24_14); also elsewhere on the board
UART_3V3_1_TX: U1.T7 (IO_L21P_T3_DQS_14); also elsewhere on the board

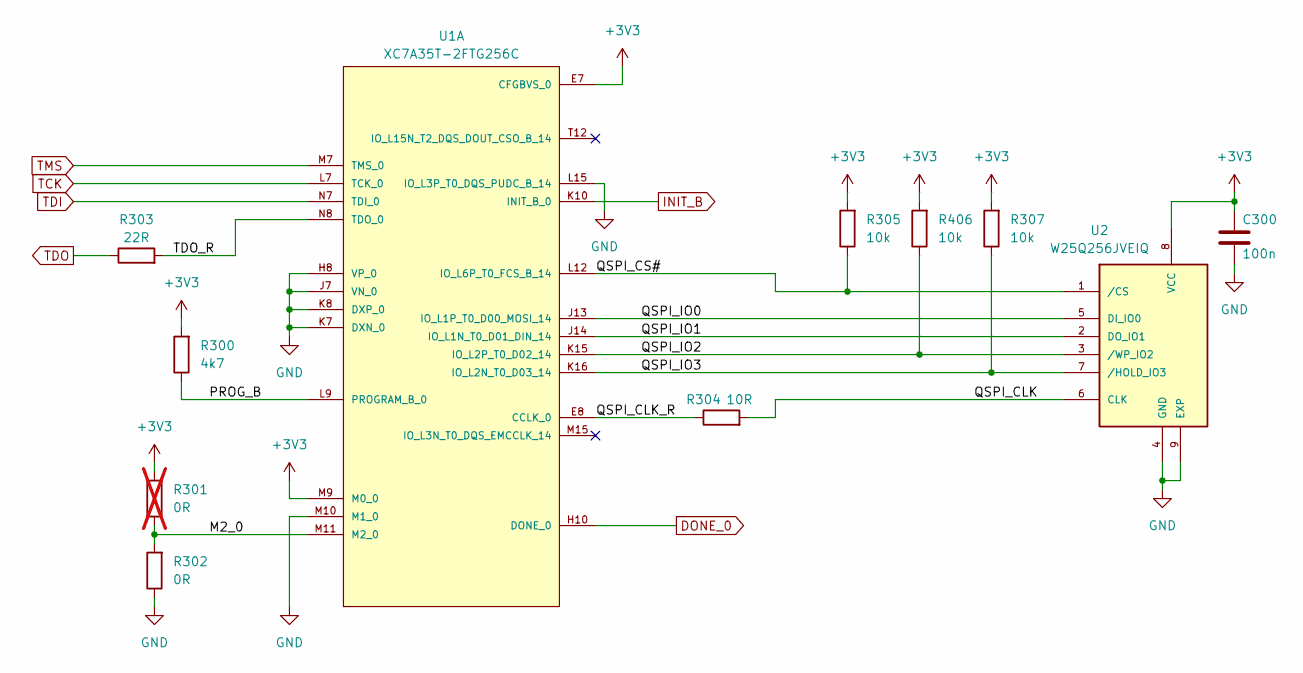
[picture p19: schematic FPGA_Config.kicad_sch, XC7A35T Configuration]

Parts:
C300: 100n; C_0402_1005Metric
R300: 4k7; R_0402_1005Metric
R301: 0R; R_0402_1005Metric; not fitted
R302: 0R; R_0402_1005Metric
R303: 22R; R_0402_1005Metric
R304: 10R; R_0402_1005Metric
R305, R307, R406: 10k; R_0402_1005Metric
U1: XC7A35T-2FTG256C; BGA256C100P16X16_1700X1700X155
U2: W25Q256JVEIQ; SON127P800X600X80-9N; MOUSER_PART_NUMBER 454-W25Q256JVEIQ

Connections:
+3V3: C300.1, R300.2, R301.2, R305.2, R307.2, R406.2, U1.E7 (CFGBVS_0), U1.M9 (M0_0), U2.8 (VCC); also elsewhere on the board
/300_FPGA_Config/M2_0: R301.1, R302.2, U1.M11 (M2_0)
/300_FPGA_Config/PROG_B: R300.1, U1.L9 (PROGRAM_B_0)
/300_FPGA_Config/QSPI_CLK: R304.2, U2.6 (CLK)
/300_FPGA_Config/QSPI_CLK_R: R304.1, U1.E8 (CCLK_0)
/300_FPGA_Config/QSPI_CS#: R305.1, U1.L12 (IO_L6P_T0_FCS_B_14), U2.1 (/CS)
/300_FPGA_Config/QSPI_IO0: U1.J13 (IO_L1P_T0_D00_MOSI_14), U2.5 (DI_IO0)
/300_FPGA_Config/QSPI_IO1: U1.J14 (IO_L1N_T0_D01_DIN_14), U2.2 (DO_IO1)
/300_FPGA_Config/QSPI_IO2: R406.1, U1.K15 (IO_L2P_T0_D02_14), U2.3 (/WP_IO2)
/300_FPGA_Config/QSPI_IO3: R307.1, U1.K16 (IO_L2N_T0_D03_14), U2.7 (/HOLD_IO3)
/300_FPGA_Config/TDO_R: R303.2, U1.N8 (TDO_0)
DONE_0: U1.H10 (DONE_0); also elsewhere on the board
GND: C300.2, R302.1, U1.H8 (VP_0), U1.J7 (VN_0), U1.K7 (DXN_0), U1.K8 (DXP_0), U1.L15 (IO_L3P_T0_DQS_PUDC_B_14), U1.M10 (M1_0), U2.4 (GND), U2.9 (EXP); also elsewhere on the board
INIT_B: U1.K10 (INIT_B_0); also elsewhere on the board
TCK: U1.L7 (TCK_0); also elsewhere on the board
TDI: U1.N7 (TDI_0); also elsewhere on the board
TDO: R303.1; also elsewhere on the board
TMS: U1.M7 (TMS_0); also elsewhere on the board

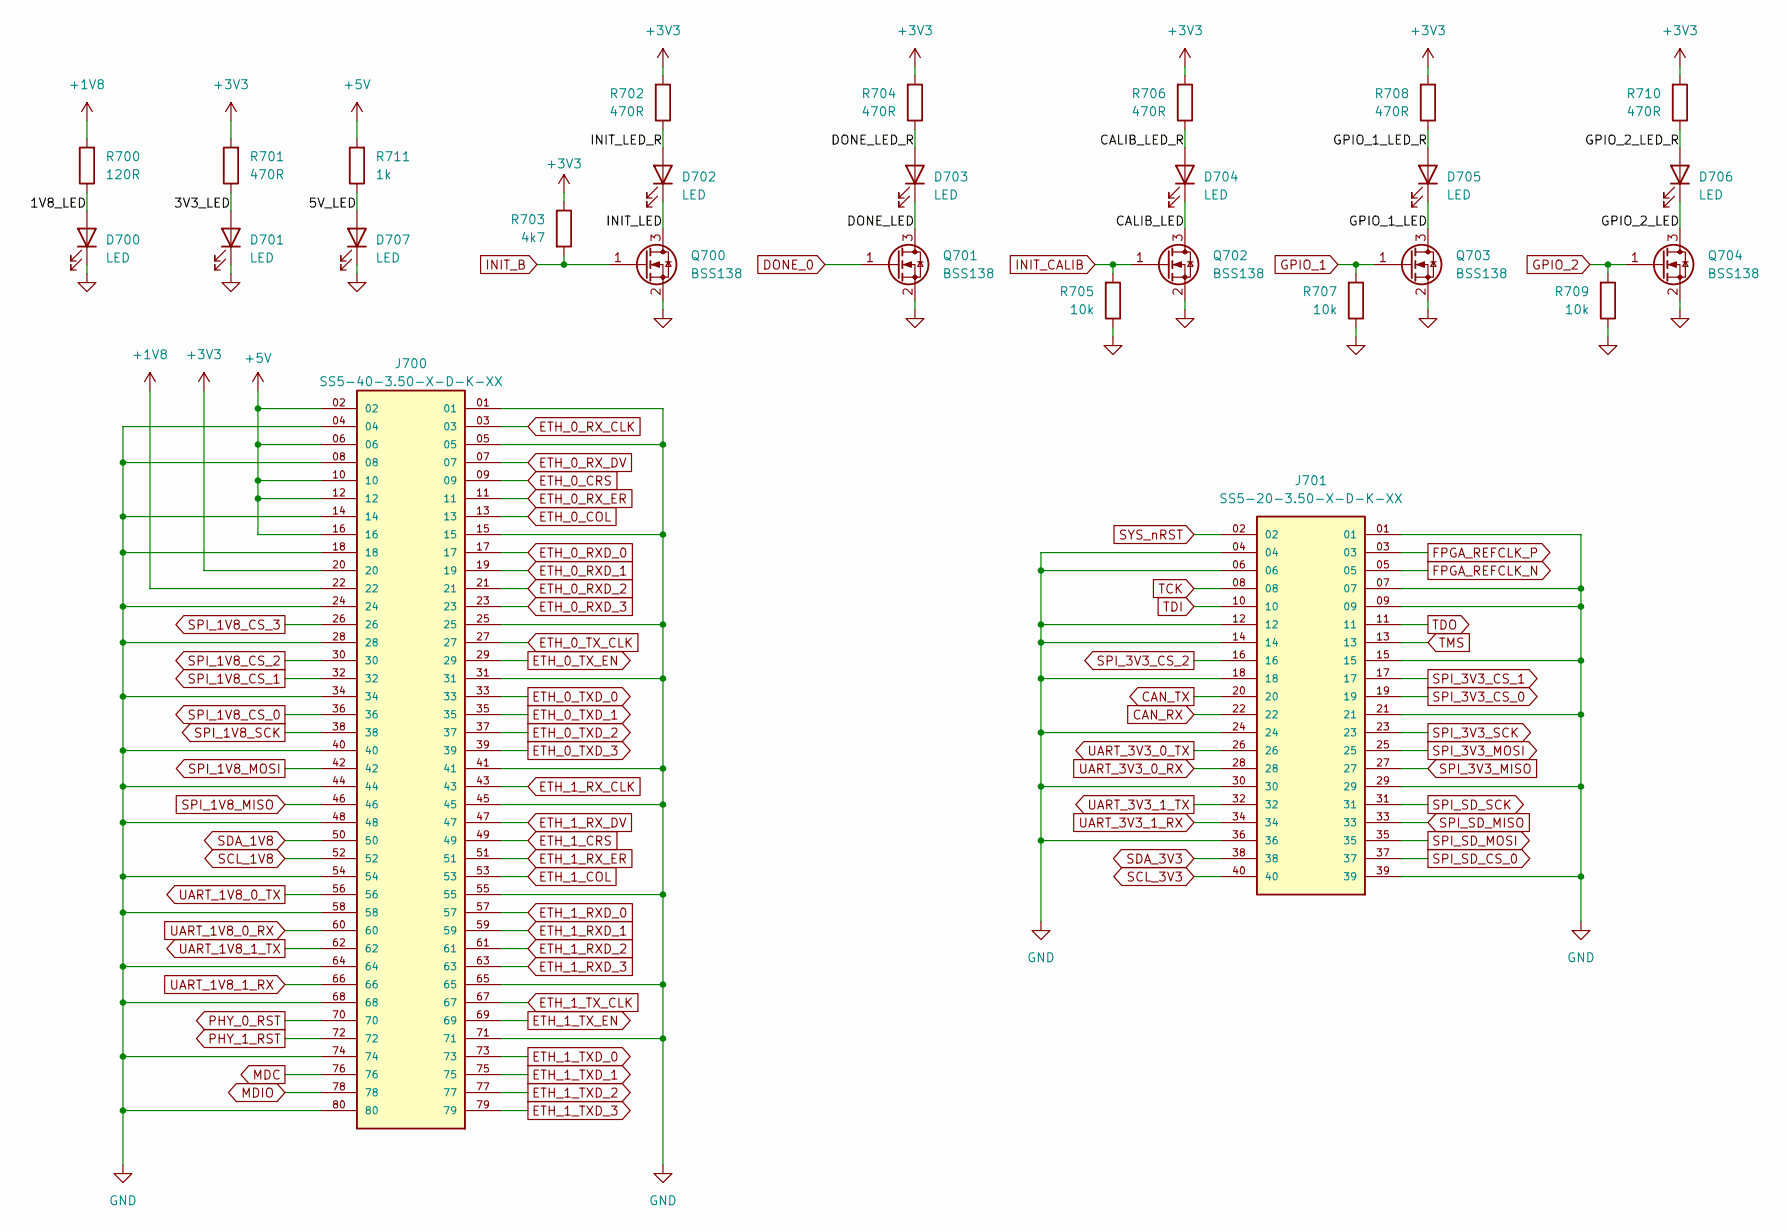
[picture p20: schematic Connectors.kicad_sch]

Parts:
D700, D701, D702, D703, D704, D705, D706, D707: LED; LED_0603_1608Metric
J700: SS5-40-3.50-X-D-K-XX; SAMTEC_SS5-40-3.50-X-D-K-XX; PARTREV F
J701: SS5-20-3.50-X-D-K-XX; SAMTEC_SS5-20-3.50-X-D-K-XX; PARTREV F
Q700, Q701, Q702, Q703, Q704: BSS138; SOT-23
R700: 120R; R_0402_1005Metric
R701, R702, R704, R706, R708, R710: 470R; R_0402_1005Metric
R703: 4k7; R_0402_1005Metric
R705, R707, R709: 10k; R_0402_1005Metric
R711: 1k; R_0402_1005Metric

Connections:
+1V8: J700.22, R700.2; also elsewhere on the board
+3V3: J700.20, R701.2, R702.2, R703.1, R704.2, R706.2, R708.2, R710.2; also elsewhere on the board
+5V: J700.02, J700.06, J700.10, J700.12, J700.16, R711.2; also elsewhere on the board
/700_Connectors/1V8_LED: D700.2 (A), R700.1
/700_Connectors/3V3_LED: D701.2 (A), R701.1
/700_Connectors/5V_LED: D707.2 (A), R711.1
/700_Connectors/CALIB_LED: D704.1 (K), Q702.3 (D)
/700_Connectors/CALIB_LED_R: D704.2 (A), R706.1
/700_Connectors/DONE_LED: D703.1 (K), Q701.3 (D)
/700_Connectors/DONE_LED_R: D703.2 (A), R704.1
/700_Connectors/GPIO_1_LED: D705.1 (K), Q703.3 (D)
/700_Connectors/GPIO_1_LED_R: D705.2 (A), R708.1
/700_Connectors/GPIO_2_LED: D706.1 (K), Q704.3 (D)
/700_Connectors/GPIO_2_LED_R: D706.2 (A), R710.1
/700_Connectors/INIT_LED: D702.1 (K), Q700.3 (D)
/700_Connectors/INIT_LED_R: D702.2 (A), R702.1
CAN_RX: J701.22; also elsewhere on the board
CAN_TX: J701.20; also elsewhere on the board
DONE_0: Q701.1 (G); also elsewhere on the board
ETH_0_COL: J700.13; also elsewhere on the board
ETH_0_CRS: J700.09; also elsewhere on the board
ETH_0_RXD_0: J700.17; also elsewhere on the board
ETH_0_RXD_1: J700.19; also elsewhere on the board
ETH_0_RXD_2: J700.21; also elsewhere on the board
ETH_0_RXD_3: J700.23; also elsewhere on the board
ETH_0_RX_CLK: J700.03; also elsewhere on the board
ETH_0_RX_DV: J700.07; also elsewhere on the board
ETH_0_RX_ER: J700.11; also elsewhere on the board
ETH_0_TXD_0: J700.33; also elsewhere on the board
ETH_0_TXD_1: J700.35; also elsewhere on the board
ETH_0_TXD_2: J700.37; also elsewhere on the board
ETH_0_TXD_3: J700.39; also elsewhere on the board
ETH_0_TX_CLK: J700.27; also elsewhere on the board
ETH_0_TX_EN: J700.29; also elsewhere on the board
ETH_1_COL: J700.53; also elsewhere on the board
ETH_1_CRS: J700.49; also elsewhere on the board
ETH_1_RXD_0: J700.57; also elsewhere on the board
ETH_1_RXD_1: J700.59; also elsewhere on the board
ETH_1_RXD_2: J700.61; also elsewhere on the board
ETH_1_RXD_3: J700.63; also elsewhere on the board
ETH_1_RX_CLK: J700.43; also elsewhere on the board
ETH_1_RX_DV: J700.47; also elsewhere on the board
ETH_1_RX_ER: J700.51; also elsewhere on the board
ETH_1_TXD_0: J700.73; also elsewhere on the board
ETH_1_TXD_1: J700.75; also elsewhere on the board
ETH_1_TXD_2: J700.77; also elsewhere on the board
ETH_1_TXD_3: J700.79; also elsewhere on the board
ETH_1_TX_CLK: J700.67; also elsewhere on the board
ETH_1_TX_EN: J700.69; also elsewhere on the board
FPGA_REFCLK_N: J701.05; also elsewhere on the board
FPGA_REFCLK_P: J701.03; also elsewhere on the board
GND: D700.1 (K), D701.1 (K), D707.1 (K), J700.01, J700.04, J700.05, J700.08, J700.14, J700.15, J700.18, J700.24, J700.25, J700.28, J700.31, J700.34, J700.40, J700.41, J700.44, J700.45, J700.48, J700.54, J700.55, J700.58, J700.64, J700.65, J700.68, J700.71, J700.74, J700.80, J701.01, J701.04, J701.06, J701.07, J701.09, J701.12, J701.14, J701.15, J701.18, J701.21, J701.24, J701.29, J701.30, J701.36, J701.39, Q700.2 (S), Q701.2 (S), Q702.2 (S), Q703.2 (S), Q704.2 (S), R705.1, R707.1, R709.1; also elsewhere on the board
GPIO_1: Q703.1 (G), R707.2; also elsewhere on the board
GPIO_2: Q704.1 (G), R709.2; also elsewhere on the board
INIT_B: Q700.1 (G), R703.2; also elsewhere on the board
INIT_CALIB: Q702.1 (G), R705.2; also elsewhere on the board
MDC: J700.76; also elsewhere on the board
MDIO: J700.78; also elsewhere on the board
PHY_0_RST: J700.70; also elsewhere on the board
PHY_1_RST: J700.72; also elsewhere on the board
SCL_1V8: J700.52; also elsewhere on the board
SCL_3V3: J701.40; also elsewhere on the board
SDA_1V8: J700.50; also elsewhere on the board
SDA_3V3: J701.38; also elsewhere on the board
SPI_1V8_CS_0: J700.36; also elsewhere on the board
SPI_1V8_CS_1: J700.32; also elsewhere on the board
SPI_1V8_CS_2: J700.30; also elsewhere on the board
SPI_1V8_CS_3: J700.26; also elsewhere on the board
SPI_1V8_MISO: J700.46; also elsewhere on the board
SPI_1V8_MOSI: J700.42; also elsewhere on the board
SPI_1V8_SCK: J700.38; also elsewhere on the board
SPI_3V3_CS_0: J701.19; also elsewhere on the board
SPI_3V3_CS_1: J701.17; also elsewhere on the board
SPI_3V3_CS_2: J701.16; also elsewhere on the board
SPI_3V3_MISO: J701.27; also elsewhere on the board
SPI_3V3_MOSI: J701.25; also elsewhere on the board
SPI_3V3_SCK: J701.23; also elsewhere on the board
SPI_SD_CS_0: J701.37; also elsewhere on the board
SPI_SD_MISO: J701.33; also elsewhere on the board
SPI_SD_MOSI: J701.35; also elsewhere on the board
SPI_SD_SCK: J701.31; also elsewhere on the board
SYS_nRST: J701.02; also elsewhere on the board
TCK: J701.08; also elsewhere on the board
TDI: J701.10; also elsewhere on the board
TDO: J701.11; also elsewhere on the board
TMS: J701.13; also elsewhere on the board
UART_1V8_0_RX: J700.60; also elsewhere on the board
UART_1V8_0_TX: J700.56; also elsewhere on the board
UART_1V8_1_RX: J700.66; also elsewhere on the board
UART_1V8_1_TX: J700.62; also elsewhere on the board
UART_3V3_0_RX: J701.28; also elsewhere on the board
UART_3V3_0_TX: J701.26; also elsewhere on the board
UART_3V3_1_RX: J701.34; also elsewhere on the board
UART_3V3_1_TX: J701.32; also elsewhere on the board

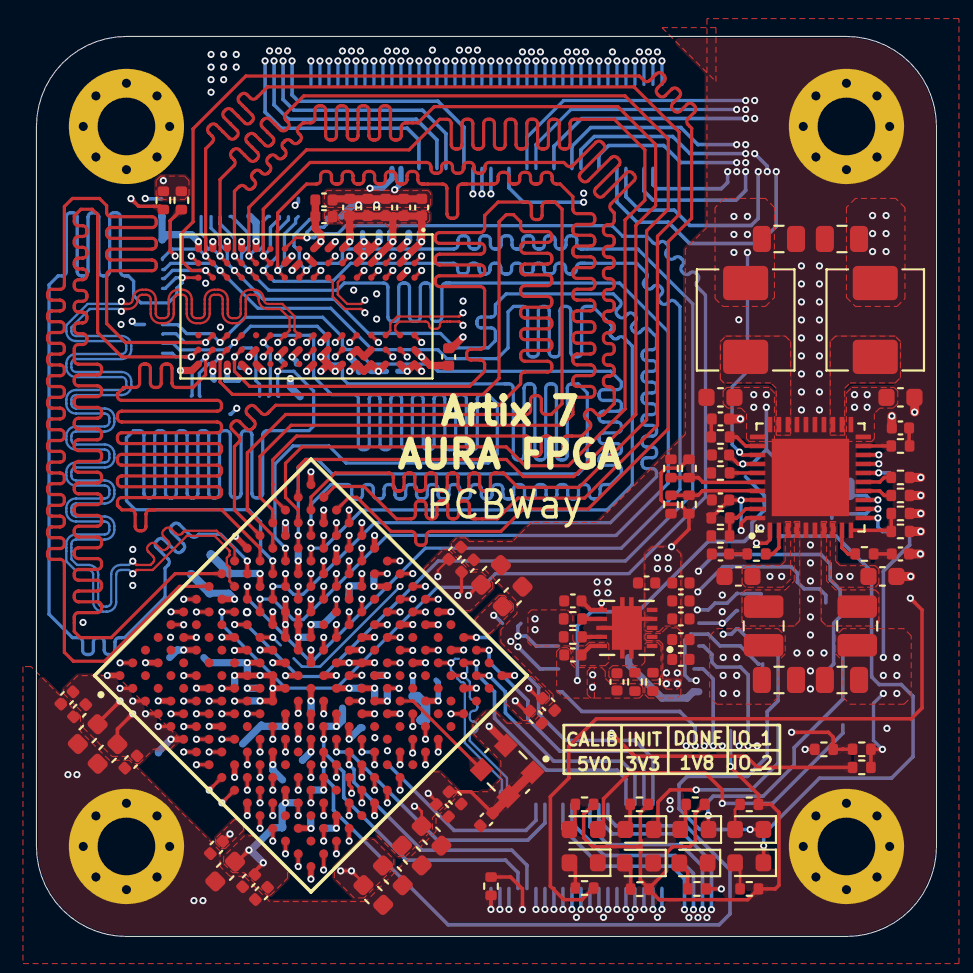
[picture p21: board FPGA_AURA.kicad_pcb from above]

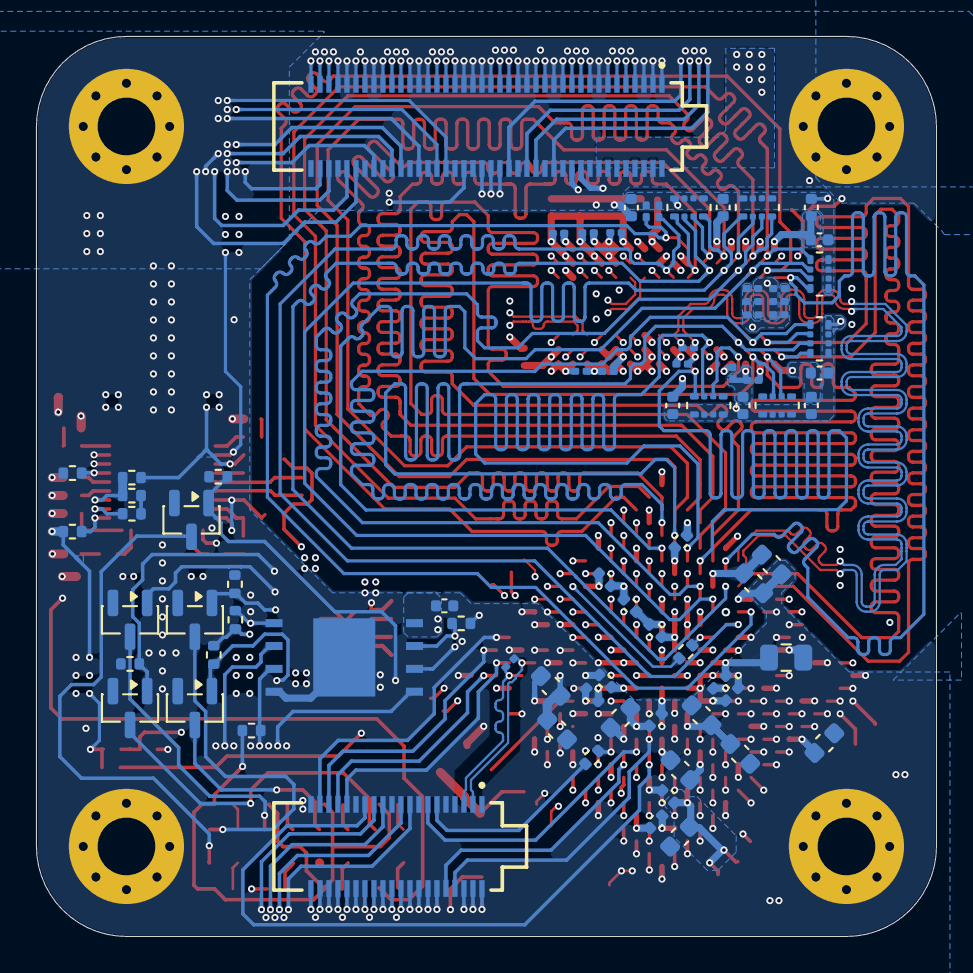
[picture p22: board FPGA_AURA.kicad_pcb from below]

Board: 10 copper layers, 50.0 x 50.0 mm, 184 parts (77 on the bottom side), 185 nets.
