alexander-armitage/AURA-FPGA/FPGA_AURA_Dev_Kit/FPGA_AURA_Dev_Kit.kicad_pcb

## KiCad design FPGA_AURA_Dev_Kit/FPGA_AURA_Dev_Kit.kicad_pcb (2026-09-24)

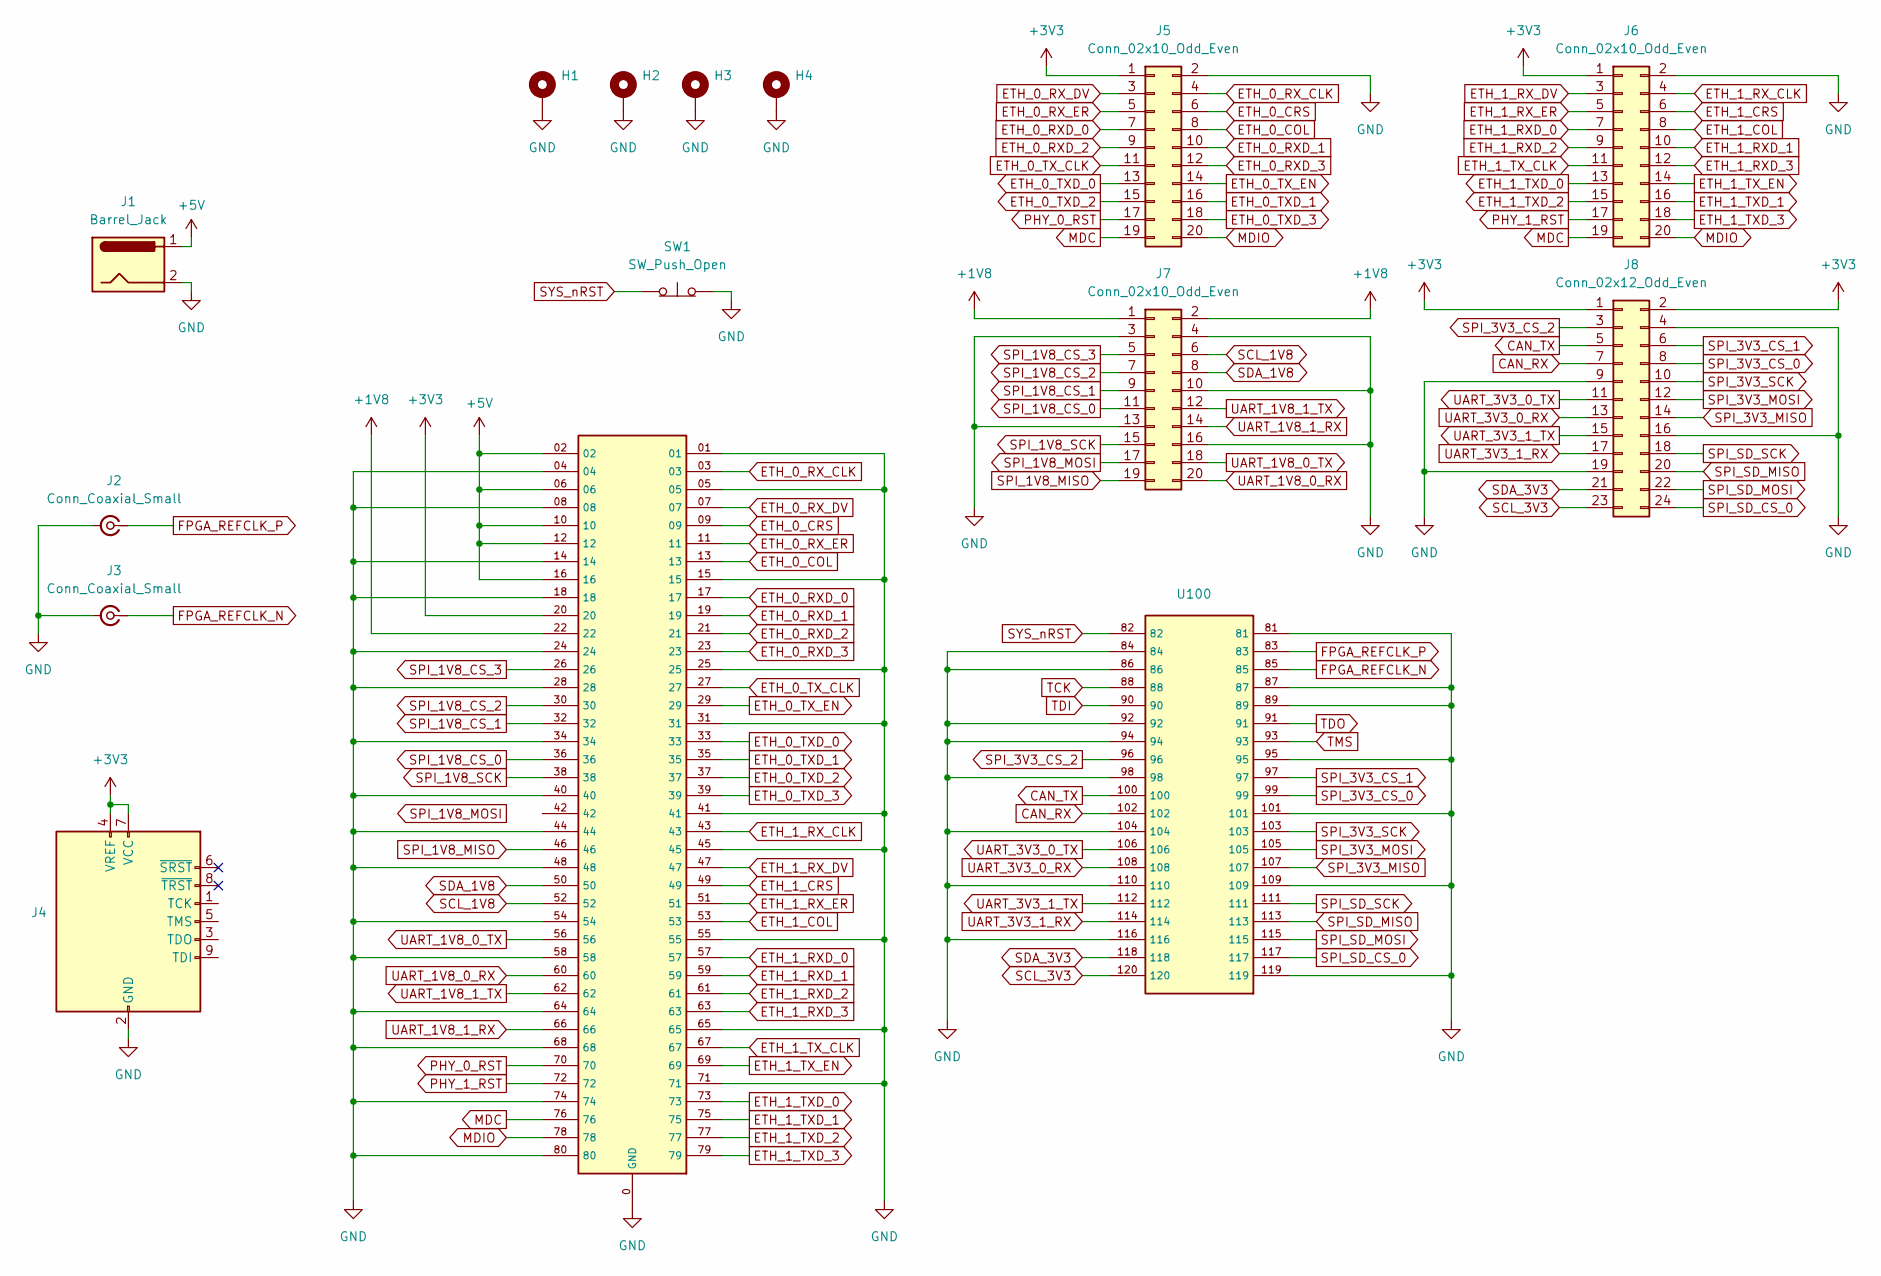
[picture p23: schematic FPGA_AURA_Dev_Kit.kicad_sch, AURA FPGA Dev Kit]

Parts:
H1, H2, H3, H4: MountingHole_Pad; MountingHole_3.2mm_M3_Pad_Via
J1: Barrel_Jack; BarrelJack_GCT_DCJ200-10-A_Horizontal
J2, J3: Conn_Coaxial_Small; SMA_Wurth_60312102114405_Vertical
J4: AVR-JTAG-10; SAMESKY_SSK05-BH-254-B5
J5, J6, J7: Conn_02x10_Odd_Even; PinHeader_2x10_P2.54mm_Vertical
J8: Conn_02x12_Odd_Even; PinHeader_2x12_P2.54mm_Vertical
SW1: SW_Push_Open; SW_SPST_CK_RS282G05A3
U100: AURA-FPGA

Connections:
+1V8: J7.1, J7.2, U100.22
+3V3: J4.4 (VREF), J4.7 (VCC), J5.1, J6.1, J8.1, J8.2, U100.20
+5V: J1.1, U100.02, U100.06, U100.10, U100.12, U100.16
CAN_RX: J8.7, U100.102
CAN_TX: J8.5, U100.100
ETH_0_COL: J5.8, U100.13
ETH_0_CRS: J5.6, U100.09
ETH_0_RXD_0: J5.7, U100.17
ETH_0_RXD_1: J5.10, U100.19
ETH_0_RXD_2: J5.9, U100.21
ETH_0_RXD_3: J5.12, U100.23
ETH_0_RX_CLK: J5.4, U100.03
ETH_0_RX_DV: J5.3, U100.07
ETH_0_RX_ER: J5.5, U100.11
ETH_0_TXD_0: J5.13, U100.33
ETH_0_TXD_1: J5.16, U100.35
ETH_0_TXD_2: J5.15, U100.37
ETH_0_TXD_3: J5.18, U100.39
ETH_0_TX_CLK: J5.11, U100.27
ETH_0_TX_EN: J5.14, U100.29
ETH_1_COL: J6.8, U100.53
ETH_1_CRS: J6.6, U100.49
ETH_1_RXD_0: J6.7, U100.57
ETH_1_RXD_1: J6.10, U100.59
ETH_1_RXD_2: J6.9, U100.61
ETH_1_RXD_3: J6.12, U100.63
ETH_1_RX_CLK: J6.4, U100.43
ETH_1_RX_DV: J6.3, U100.47
ETH_1_RX_ER: J6.5, U100.51
ETH_1_TXD_0: J6.13, U100.73
ETH_1_TXD_1: J6.16, U100.75
ETH_1_TXD_2: J6.15, U100.77
ETH_1_TXD_3: J6.18, U100.79
ETH_1_TX_CLK: J6.11, U100.67
ETH_1_TX_EN: J6.14, U100.69
FPGA_REFCLK_N: J3.1 (In), U100.85
FPGA_REFCLK_P: J2.1 (In), U100.83
GND: H1.1 (1_1), H2.1 (1_1), H3.1 (1_1), H4.1 (1_1), J1.2, J2.2 (Ext), J3.2 (Ext), J4.2 (GND), J4.10 (GND), J5.2, J6.2, J7.3, J7.4, J7.10, J7.13, J7.16, J8.4, J8.9, J8.16, J8.19, SW1.2 (B), U100.0 (GND), U100.01, U100.04, U100.05, U100.08, U100.14, U100.15, U100.18, U100.24, U100.25, U100.28, U100.31, U100.34, U100.40, U100.41, U100.44, U100.45, U100.48, U100.54, U100.55, U100.58, U100.64, U100.65, U100.68, U100.71, U100.74, U100.80, U100.81, U100.84, U100.86, U100.87, U100.89, U100.92, U100.94, U100.95, U100.98, U100.101, U100.104, U100.109, U100.110, U100.116, U100.119
MDC: J5.19, J6.19, U100.76
MDIO: J5.20, J6.20, U100.78
PHY_0_RST: J5.17, U100.70
PHY_1_RST: J6.17, U100.72
SCL_1V8: J7.6, U100.52
SCL_3V3: J8.23, U100.120
SDA_1V8: J7.8, U100.50
SDA_3V3: J8.21, U100.118
SPI_1V8_CS_0: J7.11, U100.36
SPI_1V8_CS_1: J7.9, U100.32
SPI_1V8_CS_2: J7.7, U100.30
SPI_1V8_CS_3: J7.5, U100.26
SPI_1V8_MISO: J7.19, U100.46
SPI_1V8_MOSI: J7.17
SPI_1V8_SCK: J7.15, U100.38
SPI_3V3_CS_0: J8.8, U100.99
SPI_3V3_CS_1: J8.6, U100.97
SPI_3V3_CS_2: J8.3, U100.96
SPI_3V3_MISO: J8.14, U100.107
SPI_3V3_MOSI: J8.12, U100.105
SPI_3V3_SCK: J8.10, U100.103
SPI_SD_CS_0: J8.24, U100.117
SPI_SD_MISO: J8.20, U100.113
SPI_SD_MOSI: J8.22, U100.115
SPI_SD_SCK: J8.18, U100.111
SYS_nRST: SW1.1 (A), U100.82
TCK: U100.88
TDI: U100.90
TDO: U100.91
TMS: U100.93
UART_1V8_0_RX: J7.20, U100.60
UART_1V8_0_TX: J7.18, U100.56
UART_1V8_1_RX: J7.14, U100.66
UART_1V8_1_TX: J7.12, U100.62
UART_3V3_0_RX: J8.13, U100.108
UART_3V3_0_TX: J8.11, U100.106
UART_3V3_1_RX: J8.17, U100.114
UART_3V3_1_TX: J8.15, U100.112

Board: 4 copper layers, 14 parts (0 on the bottom side), 71 nets, no tracks yet.
