alexander-armitage/AURA-FPGA/(commit log)

2026-07-19 Initial commit, moving from FPGA branch of AURA-Hardware.
    [100_Power.kicad_sch, 100_Power_Switching.kicad_sch, 200_FPGA_Config.kicad_sch, 200_Power_Regulation.kicad_sch, 300_FPGA_Banks_14_15.kicad_sch, 300_FPGA_Banks_34_35.kicad_sch, 300_FPGA_Power.kicad_sch, 400_FPGA_Banks_34_35.kicad_sch]
2026-07-19 Continued DDR3 routing on top
    [FPGA_AURA.kicad_pcb]
2026-07-20 Continued DDR3 routing.
    [FPGA_AURA.kicad_pcb]
2026-07-25 All DDR3 traces broken out, next stage is delay matching, and verifying break out through Vivado
    [Connectors.kicad_sch, FPGA_AURA.kicad_pcb]
2026-07-25 DDR3 Routing closed!
    Finally DDR3 has been routed, verified, and length matched. Further validation still required.
    [FPGA_AURA.kicad_pcb, FPGA_Banks_14_15.kicad_sch]
2026-07-26 Added AI-generated todo list, started organising repository, and clear goal defined.
    [100_Power.kicad_sch, 100_Power_Switching.kicad_sch, 200_FPGA_Config.kicad_sch, 200_Power_Regulation.kicad_sch, 300_FPGA_Banks_14_15.kicad_sch, 300_FPGA_Banks_34_35.kicad_sch, 300_FPGA_Power.kicad_sch, 400_FPGA_Banks_34_35.kicad_sch]
2026-07-31 Started pinout after successful Vivado bitstream generation.
    [FPGA_AURA.kicad_pcb, FPGA_AURA.kicad_sch, FPGA_Banks_14_15.kicad_sch, FPGA_Banks_34_35.kicad_sch]
2026-08-02 Connector pinnout defined loosly. Next is schematic clean-up followed by routing.
    [Connectors.kicad_sch, FPGA_AURA.kicad_pcb, FPGA_AURA.kicad_sch, FPGA_Banks_14_15.kicad_sch, FPGA_Banks_34_35.kicad_sch, FPGA_Config.kicad_sch]
2026-08-02 Finished schematic to start routing again, and started MII fanout from connector.
    [Connectors.kicad_sch, DDR3L.kicad_sch, FPGA_AURA.kicad_pcb, FPGA_AURA.kicad_sch, FPGA_Banks_14_15.kicad_sch, FPGA_Banks_34_35.kicad_sch, FPGA_Config.kicad_sch, FPGA_Power.kicad_sch]
2026-08-03 MII FPGA Breakout complete, pin reasignment TODO, and other peripherals
    [FPGA_AURA.kicad_pcb]
2026-08-04 All connector pins broken out. Next is QSPI flash, followed by power.
    [Connectors.kicad_sch, FPGA_AURA.kicad_pcb, FPGA_Banks_34_35.kicad_sch]
2026-08-09 Added updated schematic for reference.
2026-08-09 Updated and validated Vivado MII pin assignments.
    [FPGA_AURA.kicad_pcb]
2026-08-15 All components placed, routing left to do followed by final checks.
    [DDR3L.kicad_sch, FPGA_AURA.kicad_pcb]
2026-08-15 Power planes done on layers 3 and 4 as well as almost all mezzanine connections made. QSPI and misc left to do.
    [Connectors.kicad_sch, FPGA_AURA.kicad_pcb, FPGA_Banks_14_15.kicad_sch, FPGA_Banks_34_35.kicad_sch, FPGA_Config.kicad_sch]
2026-08-24 Continued routing, getting close to finishing. 1 Error found: DDR VREF shares same net as VREF of buck.
    [FPGA_AURA.kicad_pcb]
2026-09-05 Finishing off routing, fanning out fly by termination, and added ground pours
    [DDR3L.kicad_sch, FPGA_AURA.kicad_pcb, Power_Regulation.kicad_sch]
2026-09-07 Schematic initial draft complete.
    [Connectors.kicad_sch, DDR3L.kicad_sch, FPGA_AURA.kicad_pcb, FPGA_Banks_14_15.kicad_sch, FPGA_Config.kicad_sch, FPGA_Power.kicad_sch, Power_Regulation.kicad_sch]
2026-09-20 Connected all DDR3 bar the reset pin and routed all decoupling caps.
    [DDR3L.kicad_sch, FPGA_AURA.kicad_pcb]
2026-09-20 Continued routing and pin swapping, 11 nets left to route.
    [FPGA_AURA.kicad_pcb, FPGA_Banks_14_15.kicad_sch, FPGA_Banks_34_35.kicad_sch]
2026-09-22 Routing completely closed, DDR3 timing to be finalised, SI to be validated.
    [FPGA_AURA.kicad_pcb]
2026-09-23 Started Dev kit for bring up.
    [FPGA_AURA.kicad_pcb, FPGA_AURA_Dev_Kit.kicad_pcb, FPGA_AURA_Dev_Kit.kicad_sch]
2026-09-24 Continued dev kit. Moving focus to ordering FPGA prior to finishing dev kit.
    [FPGA_AURA_Dev_Kit.kicad_pcb, FPGA_AURA_Dev_Kit.kicad_sch]
2026-09-25 Ready to order. Gerbers exported, delay matching checked, BoM made, manufacturing information added.
    [FPGA_AURA-B_Cu.gbr, FPGA_AURA-B_Mask.gbr, FPGA_AURA-B_Paste.gbr, FPGA_AURA-B_Silkscreen.gbr, FPGA_AURA-Edge_Cuts.gbr, FPGA_AURA-F_Cu.gbr, FPGA_AURA-F_Fab.gbr, FPGA_AURA-F_Mask.gbr]
